eSpark-Backup/dustinm-lampleddriver/Design-Files/Knob-PCB-v1.0/Deliverables/Renderings/2D-C-view.png

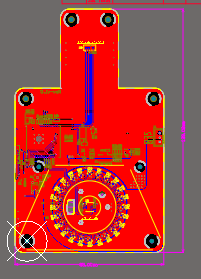
Design-Files/Knob-PCB-v1.0/Deliverables/Renderings/2D-C-view.png
