eSpark-Backup/dustinm-lampleddriver/Design-Files/Knob-PCB-v1.0/Deliverables/Renderings/3D-TOP-view.png

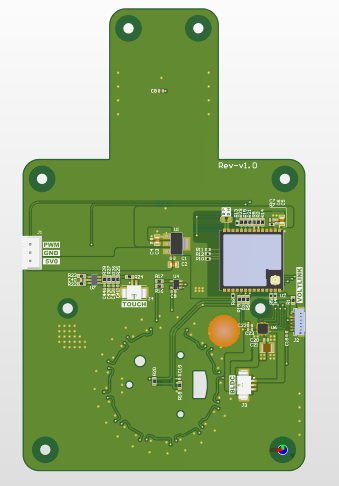
Design-Files/Knob-PCB-v1.0/Deliverables/Renderings/3D-TOP-view.png
