eSpark-Backup/dustinm-lampleddriver/Design-Files/Power-PCB-v1.0/Deliverables/Renderings/Power_PCB.JPG

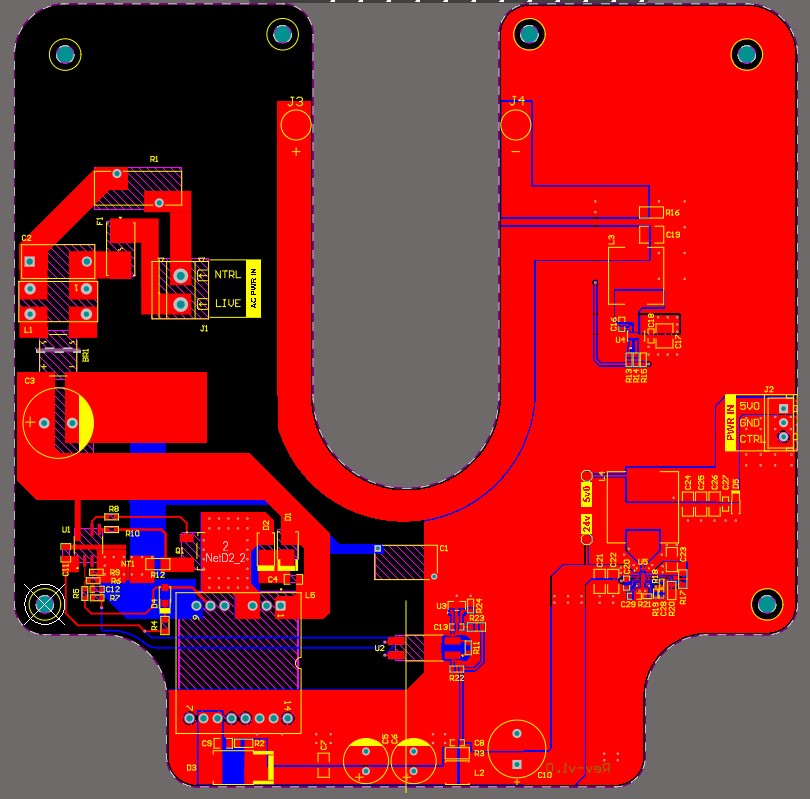
Design-Files/Power-PCB-v1.0/Deliverables/Renderings/Power_PCB.JPG
