eSpark-Backup/dustinm-lampleddriver/Design-Files/Power-PCB-v1.0/Deliverables/Renderings/Power_PCB_BOTTOM3D.jpg

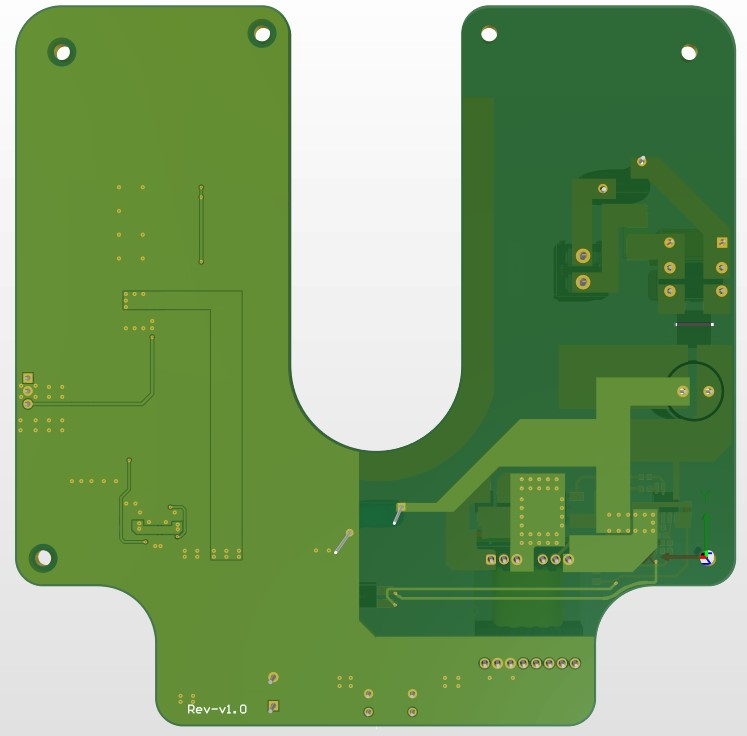
Design-Files/Power-PCB-v1.0/Deliverables/Renderings/Power_PCB_BOTTOM3D.jpg
