eSpark-Backup/dustinm-lampleddriver/docs/Client-Files/Enclosure-Files/Initial-Draft/lamp body.png

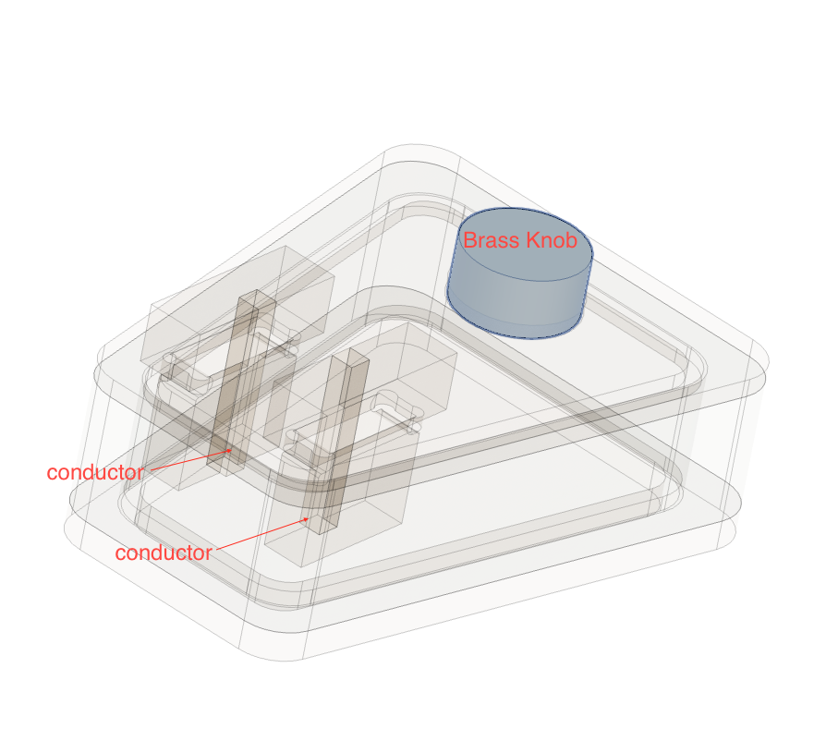
docs/Client-Files/Enclosure-Files/Initial-Draft/lamp body.png
