eSpark-Backup/dustinm-lampleddriver/Design-Files/Knob-PCB-v1.0/Deliverables/BOM/Client-BOM_Knob-PCB-v1.0.xlsx

# | Item Type | Designator | Description | Footprint | Manufacturer Part Number | Manufacturer | Value | Quantity | Remarks
1 | Capacitors | C1, C4, C6, C8, C9, C10, C11, C12, C13, C14, C15, C16, C17, C18, C19, C20, C22, C23, C24, C25, C26, C27, C28, C29, C30, C31, C32, C33, C34, C35, C36, C37, C38, C39, C40 | CAP CER 0.1UF 25V X7R 0402 | Cap-0402 | GRM155R71E104KE14D | Murata | 0.1uF | 35
2 | Capacitors | C2, C5 | CAP CER 10UF 25V X7R 0805 | Cap-0805 | GRM21BZ71E106KE15L | Murata | 10uF | 2
3 | Capacitor | C3 | CAP CER 22UF 10V X7R 0805 | Cap-0805 | GRM21BZ71A226ME15L | Murata | 22uF | 1
4 | Capacitor | C7 | CAP CER 0.1UF 16V X7R 0402 | Cap-0402 | GRM155R71C104KA88D | Murata | 0.1uF | 1
5 | Capacitor | C21 | CAP CER 22UF 25V X7R 1210 | Cap-1210 | GRM32ER71E226KE15L | Murata | 22uF | 1
6 | Capacitor | C41 | CAP CER 47PF 50V C0G/NP0 0402 | Cap-0402 | GCM1555C1H470FA16D | Murata | 47pF | 1
7 | Capacitor | C42 | CAP CER 30PF 50V C0G/NPO 0402 | Cap-0402 | CC0402JRNPO9BN300 | Yageo | 30pF | 1
8 | Capacitor | C43 | CAP CER 22PF 50V C0G/NPO 0402 | Cap-0402 | CC0402JRNPO9BN220 | Yageo | 22PF | 1
9 | Capacitors | C44 | CAP CER 13PF 50V C0G/NP0 0402 | Cap-0402 | CC0402FRNPO9BN130 | Yageo | 13pF | 1
10 | Wire To Board Connector | J1 | 1x3P 3P XH 1 Tin 2.5mm 3 -25℃~+85℃ Brass 3A Straight Plugin,P=2.5mm Wire To Board Connector ROHS | XH-3A | XH-3A | HCTL | - | 1
11 | Connector | J2 | 1x6P SH 1 1mm 6 SMD,P=1mm Wire To Board / Wire To Wire Connector ROHS | Voltlink Target | C145963 | BOOMELE | - | 1
12 | Headers and Wire Housings | J3 | CONN HEADER SMD R/A 3POS 1.25MM | 53261-0371 | 53261-0371 | Molex | - | 1
13 | Headers and Wire Housings | J4 | CONN HEADER SMD R/A 2POS 1.25MM | 532610271 | 53261-0271 | Molex | - | 1
14 | RGB LED | LED1, LED2, LED3, LED4, LED5, LED6, LED7, LED8, LED9, LED10, LED11, LED12, LED13, LED14, LED15, LED16, LED17, LED18, LED19, LED20, LED21, LED22, LED23, LED24 | 5mA -40℃~+80℃ RGB SMD,2x2mm Light Emitting Diodes (LED) ROHS | SK6812-EC20 | SK6812-EC20 | OPSCO Optoelectronics | - | 24
15 | Resistor | R1, R15, R18, R19, R21, R22, R23, R24, R27, R29 | RES 0 OHM JUMPER 1/10W 0603 | Res-0603 | RC0603JR-070RL | Yageo | 0R | 10
16 | Resistor | R2, R3, R8, R9 | RES 2.2K OHM 1% 1/10W 0603 | Res-0603 | RC0603FR-072K2L | Yageo | 2.2K | 4
17 | Resistor | R4, R5, R6, R7, R10, R11, R12, R13 | RES 10K OHM 1% 1/16W 0402 | Res-0402 | RC0402FR-0710KL | Yageo | 10K | 8
18 | Resistor | R14, R16, R20 | RES 0 OHM JUMPER 1/10W 0603 | Res-0603 | RC0603JR-070RL | Yageo | DNP | 3 | DO NOT PLACE
19 | Resistor | R17 | RES 470 OHM 1% 1/10W 0603 | Res-0603 | RC0603FR-07470RL | Yageo | 470R | 1
20 | IC | U1 | SOT-223 Linear Voltage Regulators (LDO) ROHS | SOT- 223 | AMS1117-3.3 | GUOXIN JIAPIN SEMICONDUCTOR | - | 1
21 | Module | U2 | RF TXRX MOD BT WIFI PCB TH SMD | ESP32-C6-WROOM-1U-N8 | ESP32-C6-WROOM-1U-N8 | Espressif Systems | - | 1
22 | Sensors | U3 | SENSOR OPT AMBIENT 4 SMD J LEAD | VEML7700-TT | VEML7700-TT | Vishay Semiconductors | - | 1
23 | IC | U4 | IC BUF NON-INVERT 5.5V SOT23-5 | SOT-23-5 | SN74LV1T34DBVR | Texas Instruments | - | 1
24 | Sensor | U5 | SOP-8 Position Sensors ROHS | SOP-8 | MT6701CT-STD | Magn Tek | - | 1
25 | IC | U6 | BLDC MOTOR DRIVER 2-11V QFN20 | 20-QFN(3x3) | TMC6300-LA-T | Trinamic | - | 1
26 | IC | U7 | SOT-23-6L Touch Sensors ROHS | SOT-23-6 | TTP233H-BA6 | Tontek Design Tech | - | 1
27 | Peripheral | Antenna | high gain embedded 2.4g Wifi U.FL Ble FPC Flexible Antenna ufl internal Antenna flexible Ble BT Antenna for ESP32 Module | custom | ZXWIFI24I408 | Signal Plus | - | 1
28 | Peripheral | Motor | Three Phase Brushless Gimbal Stabilizer Motor | custom | EM3215 3-Phase Brushless DC Motor | SparkFun | - | 1
