eSpark-Backup/dustinm-lampleddriver/Design-Files/Power-PCB-v1.0/Deliverables/BOM/Client-BOM_Power-PCB-v1.0.xlsx

# | Item Type | Designator | Description | Footprint | Manufacturer Part Number | Manufacturer | value | Quantity | Remarks
1 | Bridge Rectifire | BR1 | 1.1V@4A 4A 1000V UMSB Bridge Rectifiers ROHS | - | MSB40M | GOODWORK | - | 1
2 | Capacitor | C1 | 1.5nF ±20% X1,Y1 Plugin,P=10mm Safety Capacitors ROHS | - | DCF152M36Y5UG6BL0AA | SHM | 1.5nF | 1
3 | Capacitor | C2 | 100nF ±10% X2 275V Plugin,P=10mm Safety Capacitors ROHS | - | MP2104K27C3X6LC | SRD(Shenzhen Sincerity Tech) | 100nF | 1
4 | Capacitor | C3 | 82uF 250V 1.35Ω@100kHz ±20% 1.27A@100kHz Plugin,D12.5xL20mm Aluminum Electrolytic Capacitors - Leaded ROHS | - | LKML2002E820MF | Ymin | 82uF | 1
5 | Capacitor | C4, C9 | 630V 1000pF X7R ±10% 0805 Multilayer Ceramic Capacitors MLCC - SMD/SMT ROHS | Cap-0805 | 0805B102K631NT | FH (Guangdong Fenghua Advanced Tech) | 1000pF | 2
6 | Capacitor | C5, C6 | 220uF 35V 472.5mA@120Hz ±20% Plugin,D8xL11.5mm Aluminum Electrolytic Capacitors - Leaded ROHS | - | 35ZLH220MEFC8X11.5 | Rubycon | 220uF | 2
7 | Capacitor | C7 | CAP CER 6.8UF 35V X7R 1206 | Cap-1206 | C3216X7R1V685K160AC | TDK Corporation | 6.8uF | 1
8 | Capacitors | C8, C16, C18 | CAP CER 0.1UF 50V X7R 0603 | Cap-0603 | GCM188R71H104KA57J | Murata | 0.1uF | 3
9 | Capacitor | C10 | CAP ALUM 470UF 20% 35V RADIAL | - |  |  | 470uF | 1
10 | Capacitor | C11 | 35V 10uF X5R ±10% 0805 Multilayer Ceramic Capacitors MLCC - SMD/SMT ROHS | Cap-0805 | CGA0805X5R106K350MT | HRE | 10uF | 1
11 | Capacitors | C12 | CAP CER 0.047UF 50V X7R 0603 | Cap-0603 | CC0603KRX7R9BB473 | Yageo | 47nF | 1
12 | Capacitors | C13 | CAP CER 560PF 50V X7R 0603 | Cap-0603 | CC0603KRX7R9BB561 | Yageo | 560pF | 1
13 | Capacitors | C17, C19 | CAP CER 10UF 50V X7R 1210 | Cap-1210 | CC1210KKX7R9BB106 | Yageo | 10uF | 2
14 | Capacitor | C20, C27 | CAP CER 0.1UF 50V X7R 0603 | Cap-0603 |  |  | 0.1uF | 2
15 | Capacitor | C21 | CAP CER 4.7UF 50V X7R 1206 | Cap-1206 | UMK316AB7475KL-T | Taiyo Yuden | 4.7uF | 1
16 | Capacitor | C22, C23 | CAP CER 0.22UF 50V X7R 1206 | Cap-1206 | CC1206JKX7R9BB224 | Yageo | 220nF | 2
17 | Capacitor | C24, C25, C26 | CAP CER 47UF 25V X5R 1206 | Cap-1206 | GRM31CR61E476ME44L | Murata | 47uF | 3
18 | Capacitor | C28 | CAP CER 6.8PF 50V C0G/NPO 0402 | Cap-0402 | CC0402CRNPO9BN6R8 | Yageo | 6.8pF | 1
19 | Capacitor | C29 | CAP CER 1UF 50V X5R 0603 | Cap-0603 | CL10A105KB8NNNC | Samsung | 1uF | 1
20 | TVS Diodes | D1 | TVS DIODE 170VWM 275VC SMB | SMB_ | SMBJ170A-TR | STMicroelectronics | - | 1
21 | Diodes | D2 | DIODE STANDARD 1000V 1A SMA | SMA(DO-214AC) | US1M-13-F | Diodes | - | 1
22 | Diode | D3 | 200V Independent Type 4A 860mV@4A SMC(DO-214AB) Schottky Diodes ROHS | SMC | MBRS4201T3G | FUXINSEMI | - | 1
23 | Schottky Diodes | D4 | DIODE SCHOTTKY 100V 1A SOD123W | SOD-123W | PMEG10010ELRX | Nexperia | - | 1
24 | (TVS/ESD) | D5 | 6V 5V SOD-123 ESD and Surge Protection (TVS/ESD) ROHS | SOD-123 | AZ3005-01G | AMAZING | - | 1
25 | Fuses | F1 | FUSE BRD MNT 3A 125VAC/VDC 2SMD | - | 0154003.DR | Littelfuse | - | 1
26 | Terminal Block | J1 | 1x2P 18A -40℃~+105℃ 250V Black 12~30 Straight pin 5.08mm 2.5 1 2 Plugin,P=5.08mm Screw terminal ROHS | - | DB128L-5.08-2P-BK-S | DIBO | - | 1
27 | Wire To Board Connector | J2 | 1x3P 3P XH 1 Tin 2.5mm 3 -25℃~+85℃ Brass 3A Straight Plugin,P=2.5mm Wire To Board Connector ROHS | - | XH-3A | HCTL | - | 1
28 | Fixed Inductors | L1 | CMC 1MH 2A 2LN TH | - | 744821201 | Wurth Electronics | - | 1
29 | Inductor | L2 | 3.4A 1uH ±30% 5.9A SMD,4x4mm Power Inductors ROHS | - | CR4030-1R0N | Ceaiya | - | 1
30 | Inductor | L3 | 4.5A 4.7uH ±20% SMD,10.1x10.1mm Power Inductors ROHS | - | YSLF1045-4R7M | YJYCOIN | 4.7uH | 1
31 | Inductors | L4 | FIXED IND 15UH 9A 28 MOHM SMD | - | SRP1265A-150M | Bourns | 15uH | 1
32 | Transformer | L5 | XFMR FLYBACK AC/DC CONV 280UH TH | - | 750343466 | Wurth Electronics | - | 1
33 | Mosfet | Q1 | 650V 7A 0.6Ω@10V,3.5A 63W 4V 1 N-channel TO-252-2 MOSFETs ROHS | TO-252-2L | SM600R65CT9RL | SPS | - | 1
34 | Thermistor | R1 | 5Ω 5A 4W 2800K ±10% Plugin,P=7.5mm NTC Thermistors ROHS | - | MF72 5D13 | Nanjing Shiheng Elec | - | 1
35 | Resistors | R2, R4 | RES 10 OHM 5% 1/8W 0805 | RES-0805 | RC0805JR-0710RL | Yageo | 10R | 2
36 | Resistor | R3 | 0.25W Thick Film Resistors 200V ±1% ±200ppm/℃ 2Ω 1206 Chip Resistor - Surface Mount ROHS | Res-1206 | FRC1206F2R00TS | FOJAN | 2R | 1
37 | Resistor | R5 | RES 75K OHM 1% 1/10W 0603 | Res-0603 | RC0603FR-0775KL | Yageo | 75K | 1
38 | Resistors | R6 | RES 24K OHM 5% 1/10W 0603 | Res-0603 | RC0603JR-0724KL | Yageo | 24K | 1
39 | Resistors | R7, R15 | RES 100K OHM 1% 1/10W 0603 | Res-0603 | RC0603FR-07100KL | Yageo | 100K | 2
40 | Resistor | R8, R13 | RES 0 OHM JUMPER 1/10W 0603 | Res-0603 | RC0603JR-070RL | Yageo | 0R | 2
41 | Resistors | R9 | RES 22K OHM 1% 1/10W 0603 | Res-0603 | RC0603FR-0722KL | Yageo | 22K | 1
42 | Resistors | R10 | RES 2.7K OHM 5% 1/10W 0603 | Res-0603 | RC0603JR-072K7L | Yageo | 2.7K | 1
43 | Resistor | R11, R14 | 0.1W Thick Film Resistors 75V ±100ppm/℃ ±1% 1kΩ 0603 Chip Resistor - Surface Mount ROHS | Res-0603 | 0603WAF1001T5E | UNI-ROYAL(Uniroyal Elec) | 1K | 2
44 | Resistor | R12 | 0.25W Thick Film Resistors 500V ±1% ±300ppm/℃ 0.43Ω 1206 Chip Resistor - Surface Mount ROHS | Res-1206 | FRL1206FR430TS | FOJAN | 0.43R | 1
45 | Resistor | R16 | RES 0.2 OHM 1% 1/2W 1206 | Res-1206 | PT1206FR-7W0R2L | Yageo | 0.2R | 1
46 | Resistor | R17 | RES SMD 698K OHM 0.1% 1/8W 0805 | RES-0805 | RT0805BRD07698KL | Yageo | 698K | 1
47 | Resistor | R18, R19 | RES SMD 100K OHM 0.1% 1/16W 0402 | Res-0402 | RT0402BRD07100KL | Yageo | 100K | 2
48 | Resistors | R20 | RES SMD 51.1K OHM 0.1% 1/8W 0805 | RES-0805 | RT0805BRD0751K1L | Yageo | 51.1K | 1
49 | Resistors | R21 | RES SMD 24.9KOHM 0.1% 1/16W 0402 | Res-0402 | RT0402BRD0724K9L | Yageo | 24.9K | 1
50 | Resistor | R22 | RES 1.5K OHM 1% 1/10W 0603 | Res-0603 | RC0603FR-071K5L | Yageo | 1.5K | 1
51 | Resistors | R23 | RES SMD 383K OHM 0.1% 1/8W 0805 | RES-0805 | RT0805BRD07383KL | Yageo | 383K | 1
52 | Resistors | R24 | RES 44.2K OHM 1% 1/10W 0603 | Res-0603 | RC0603FR-0744K2L | Yageo | 44.2K | 1
53 | IC | U1 | IC OFFLINE SWITCH FLYBACK 7SOIC | 7-SOIC | UCC28740DR | Texas Instruments | - | 1
54 | Optocouplers | U2 | OPTOISOLATOR 5KV 1CH TRANS 4-SMD | - | LTV-817S-TA1-C | Vishay Lite-On | - | 1
55 | IC | U3 | IC VREF SHUNT ADJ 0.5% SOT23-3 | SOT-23 | TL431BQDBZT | Texas Instruments | - | 1
56 | IC | U4 | IC LED DRV RGLTR PWM SOT23-THIN | SOT-23-6 | TPS92200D2DDCR | Texas Instruments | - | 1
57 | IC | U5 | IC REG BUCK ADJ 4A 13WQFN | 13-WQFN-HR (3x2) | LM60440AQRPKRQ1 | Texas Instruments | - | 1
