eSpark-Backup/dustinm-lampleddriver/Design-Files/Knob-PCB-v1.0/Deliverables/Supporting Files/Knob-v1.0.step

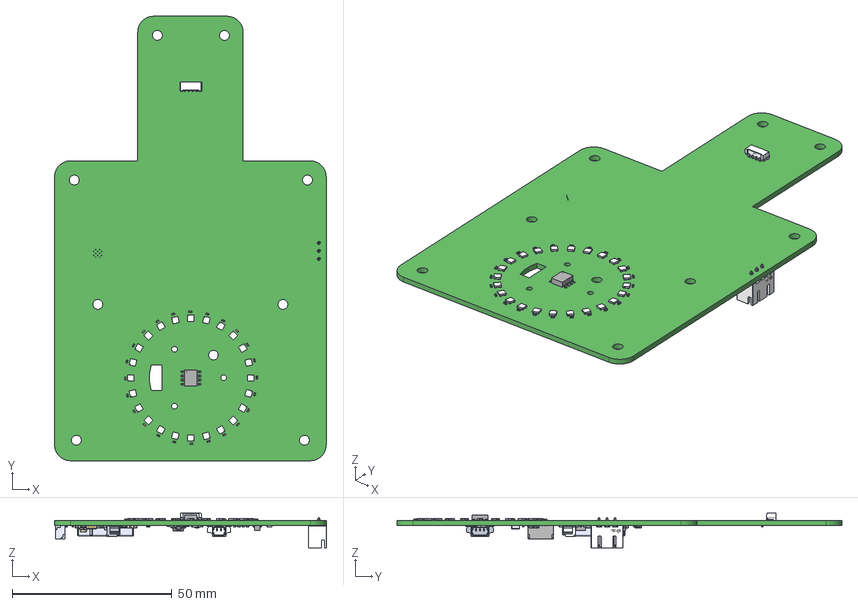
[picture p11: CAD file, 2025-07-10]
Design-Files/Knob-PCB-v1.0/Deliverables/Supporting Files/Knob-v1.0.step
85.1 x 139.1 x 10.9 mm
ESP32-C6-WROOM-1U-N8-board
antenna jack
21-0058I_MXM
User Library-RESC1608X05N x 21
User Library-RES_1005-0402 x 8
User Library-Capacitor 0402 x 40
OPSCO-Optoelectronics-SK6812-EC20_C2909058 x 24
EFM8UB30F40G-A-QFN20
TRANS_IRF7103TRPBF_INF
SN74LV1T34DBVR
User Library-SOT-223-1
SOLID.step.STEP.dwg.STEP.STEP.dwg
User Library-CAPC3225X10
User Library-0805 SMD Capacitor x 3
