eSpark-Backup/dustinm-lampleddriver/docs/Client-Files/Enclosure-Files/Casing-Draft-Final/knob-board-hole-update.step

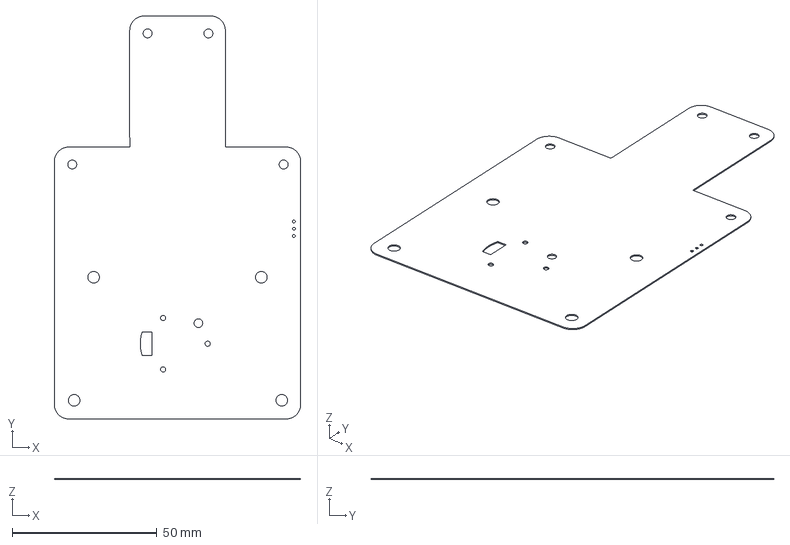
[picture p12: CAD file, 2025-06-02]
docs/Client-Files/Enclosure-Files/Casing-Draft-Final/knob-board-hole-update.step
85.0 x 139.1 x 0.411 mm
