eSpark-Backup/dustinm-lampleddriver/docs/Client-Files/Enclosure-Files/Final-Rectangular-Draft/Lamp_rectangular_base v2.step

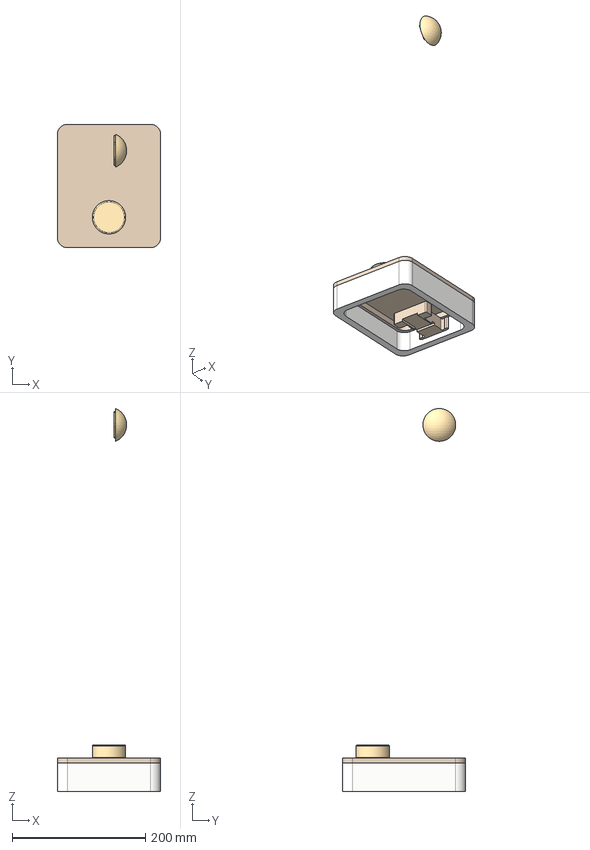
[picture p13: CAD file, 2025-04-04]
docs/Client-Files/Enclosure-Files/Final-Rectangular-Draft/Lamp_rectangular_base v2.step
155.0 x 185.0 x 574.6 mm
knob
semisphere left
rectangular top
tower hold down
concrete
