eSpark-Backup/dustinm-lampleddriver/docs/Client-Files/Enclosure-Files/Initial-Draft/lamp_base_with_konb_and_cord_hole.step

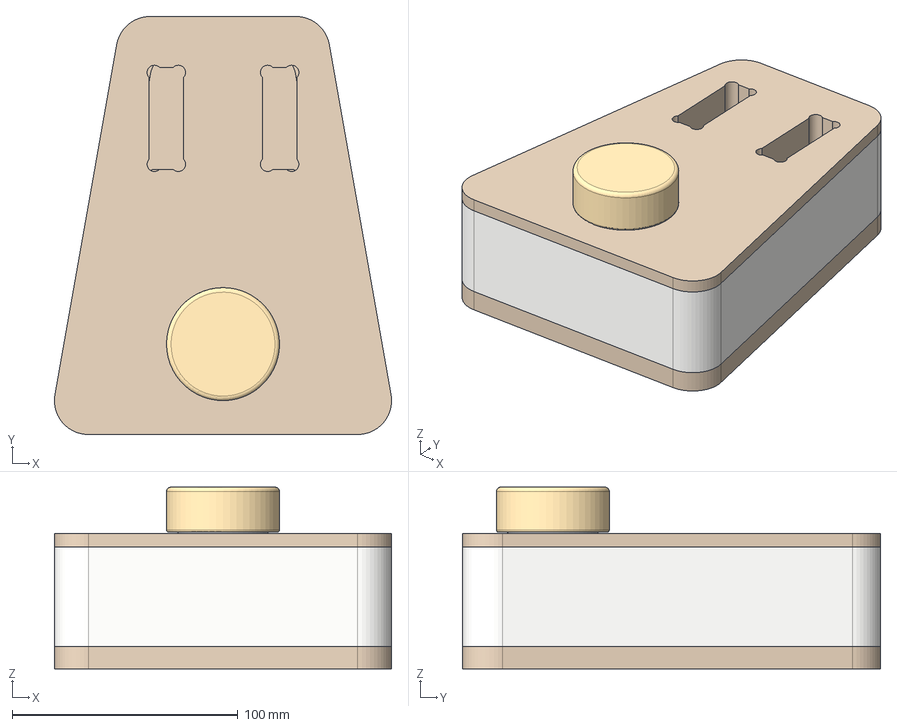
[picture p14: CAD file, 2025-03-17]
docs/Client-Files/Enclosure-Files/Initial-Draft/lamp_base_with_konb_and_cord_hole.step
149.2 x 185.0 x 80.5 mm
Stator
Rotor
knob
alt base top
alt base bottom
concrete
tower hold down
Main PCB
