eSpark-Backup/dustinm-lampleddriver/docs/Client-Files/Enclosure-Files/LED-Board-Draft/LED_board_mockup.step

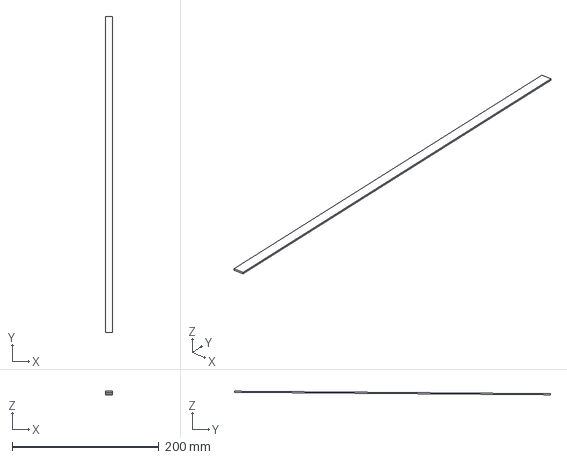
[picture p15: CAD file, 2025-03-17]
docs/Client-Files/Enclosure-Files/LED-Board-Draft/LED_board_mockup.step
10.0 x 431.0 x 4.92 mm
