eSpark-Backup/dustinm-lampleddriver/docs/Client-Files/Enclosure-Files/Triangular-Draft/Lamp_triangular_base v1.step

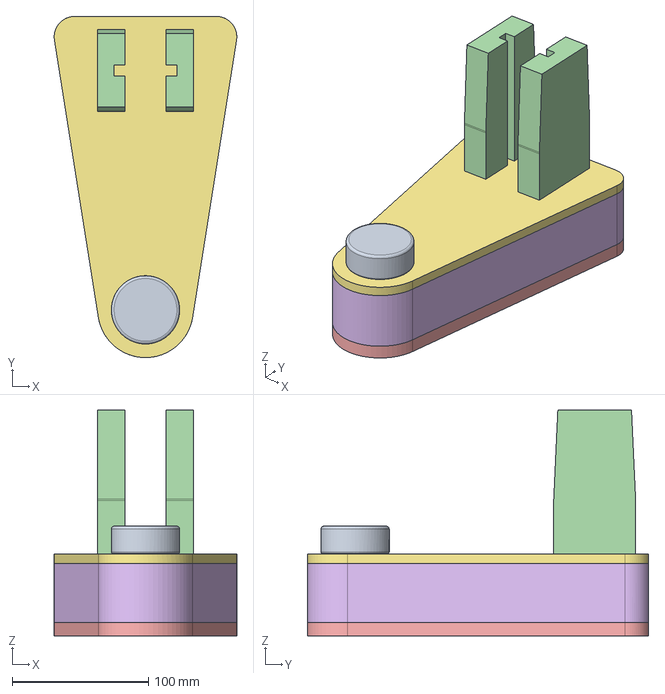
[picture p16: CAD file, 2025-03-18]
docs/Client-Files/Enclosure-Files/Triangular-Draft/Lamp_triangular_base v1.step
133.9 x 250.0 x 165.6 mm
Rotor
Stator
