eSpark-Backup/dustinm-lampleddriver/docs/Client-Files/Enclosure-Files/Casing-Draft-Final/knob_pcb_with_motor_mount_4-29-25.step

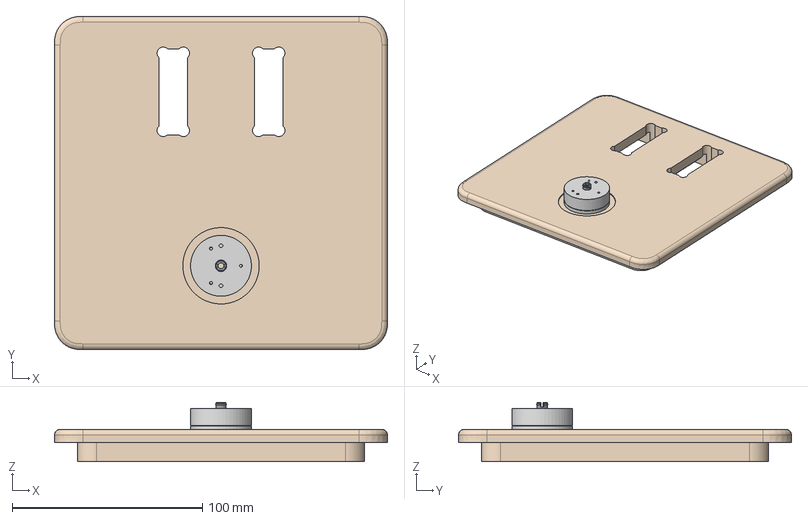
[picture p17: CAD file, 2025-05-02]
docs/Client-Files/Enclosure-Files/Casing-Draft-Final/knob_pcb_with_motor_mount_4-29-25.step
175.0 x 175.0 x 31.2 mm
Top
Stator
Rotor
MountBase v1
knob pcb (1)
