eSpark-Backup/dustinm-lampleddriver/docs/Client-Files/Enclosure-Files/Initial-Draft/lamp_body.step

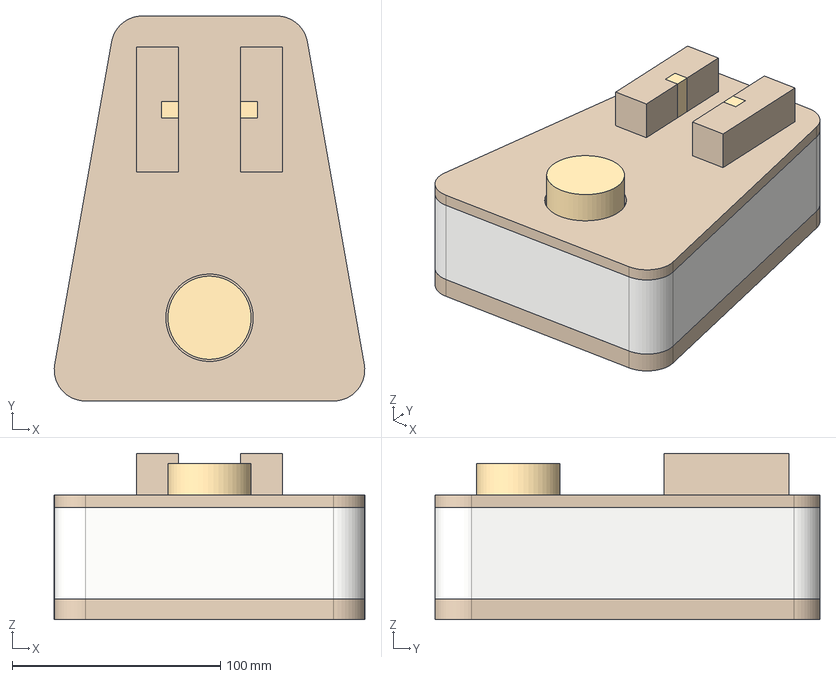
[picture p18: CAD file, 2025-03-11]
docs/Client-Files/Enclosure-Files/Initial-Draft/lamp_body.step
149.2 x 185.0 x 80.0 mm
knob
alt base top
tower left
bar
alt base bottom
concrete
