eSpark-Backup/dustinm-lampleddriver/docs/Client-Files/Enclosure-Files/Casing-Draft-Final/Lamp_rectangular_base v11_175mm.step

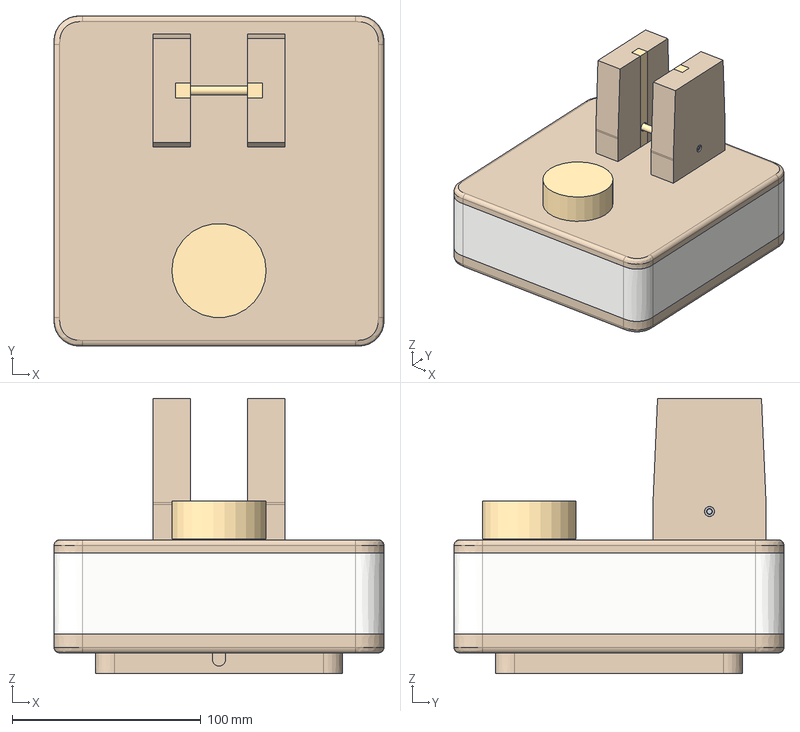
[picture p19: CAD file, 2025-04-11]
docs/Client-Files/Enclosure-Files/Casing-Draft-Final/Lamp_rectangular_base v11_175mm.step
175.0 x 175.0 x 146.0 mm
tower
spacer
bar
hold down
Main PCB
knob
Top
Middle
Base
Base Ring
95807A520_Stainless Steel Tapping Insert for Hardwood
91290A204_Alloy Steel Socket Head Screw
91290A123_Alloy Steel Socket Head Screw
91290A123_Alloy Steel Socket Head Screw_3 x 2
91290A123_Alloy Steel Socket Head Screw_1
91290A123_Alloy Steel Socket Head Screw_2
95807A520_Stainless Steel Tapping Insert for Hardwood_1
95631A050_Brass Tapping Inserts for Hardwood
magnet
sleeve
91290A204_Alloy Steel Socket Head Screw_1
95631A050_Brass Tapping Inserts for Hardwood_1
95631A050_Brass Tapping Inserts for Hardwood_2
95631A050_Brass Tapping Inserts for Hardwood_3
magnet base ring2
magnet base ring 3
magnet base ring 4
magnet bottom 3
magnet bottom 4
Stator
Rotor
tower(Mirror)
bar(Mirror)
sleeve(Mirror)
91290A123_Alloy Steel Socket Head Screw_4
90593A005_Black-Oxide Steel Hex Nut
cord reel
070-5643_6A
070-5643_coil
150-2107_6B x 2
96144A135_Fine-Thread Alloy Steel Socket Head Screw
Main PCB (1)
pogo pins
