eSpark-Backup/dustinm-lampleddriver/Design-Files/Knob-PCB-v1.0/Deliverables/Suppoting Files/Knob-v1.0.step

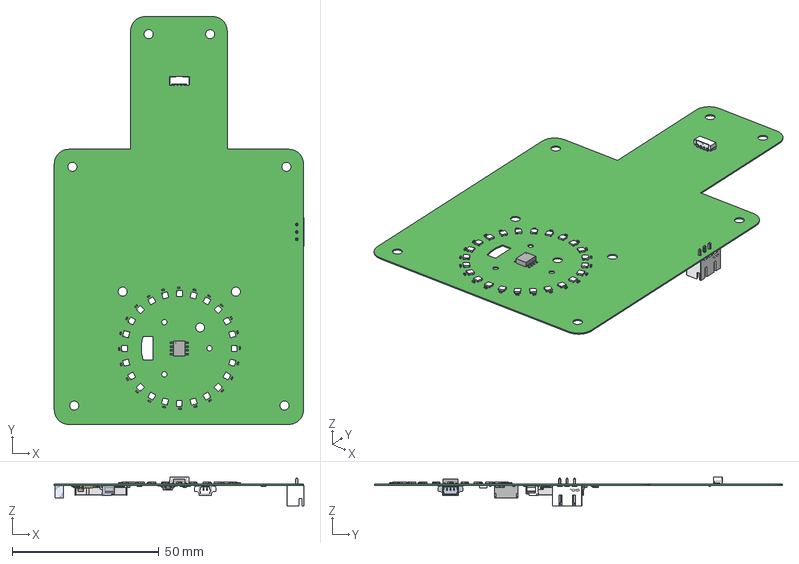
[picture p20: CAD file, 2025-06-02, an earlier design]
Design-Files/Knob-PCB-v1.0/Deliverables/Suppoting Files/Knob-v1.0.step
85.1 x 139.1 x 9.76 mm
OPSCO-Optoelectronics-SK6812-EC20_C2909058 x 24
User Library-RESC1608X05N x 13
ESP32-S3-WROOM-1U--3DModel-STEP-56544
User Library-Capacitor 0402 x 35
EFM8UB30F40G-A-QFN20
TRANS_IRF7103TRPBF_INF
SN74LV1T34DBVR
User Library-SOT-223-1
User Library-RES_1005-0402 x 7
SOLID.step.STEP.dwg.STEP.STEP.dwg
User Library-CAPC3225X10
User Library-0805 SMD Capacitor x 3
