eSpark-Backup/dustinm-lampleddriver/(list of files, cad)

Other CAD files:
Design-Files/Power-PCB-v1.0/Deliverables/Supporting Files/Power-PCB-v1.0D.DWG
Design-Files/Power-PCB-v1.0/Deliverables/Supporting Files/Power-PCB-v1.0.DXF
Design-Files/Knob-PCB-v1.0/Deliverables/Supporting Files/Knob-v1.0.DWG
Design-Files/Knob-PCB-v1.0/Deliverables/Supporting Files/Knob-v1.0.DXF
Design-Files/Knob-PCB-v1.0/Deliverables/Suppoting Files/Knob-v1.0.DXF
