eSpark-Backup/dustinm-lampleddriver/Design-Files/Knob-PCB-v1.0/Schematic/Knob-PCB-v1.0.pdf

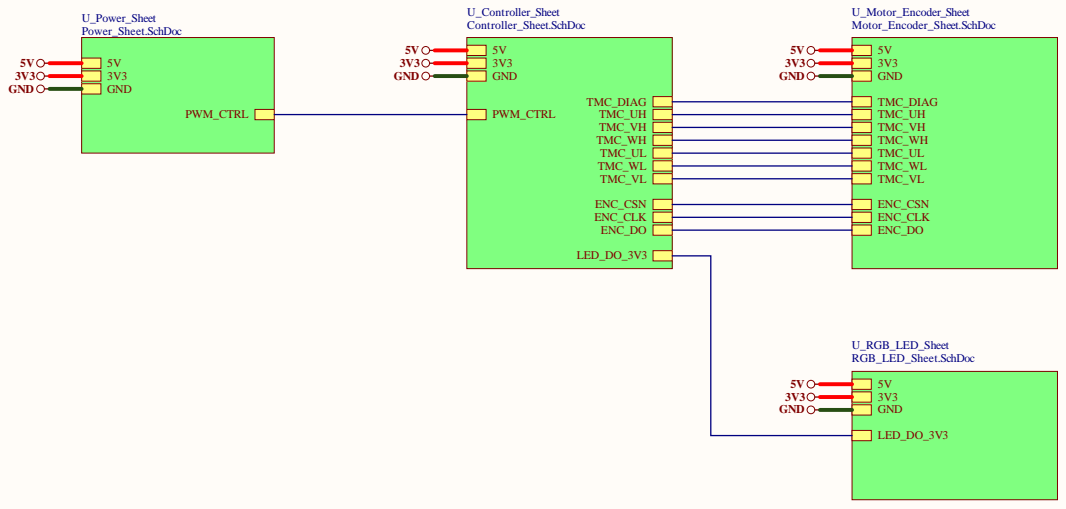
[picture p21: page 1]

Date: 07-Jul-25 | Page Num: 1

Drawn By: Huzaifa Ali | Page Total:

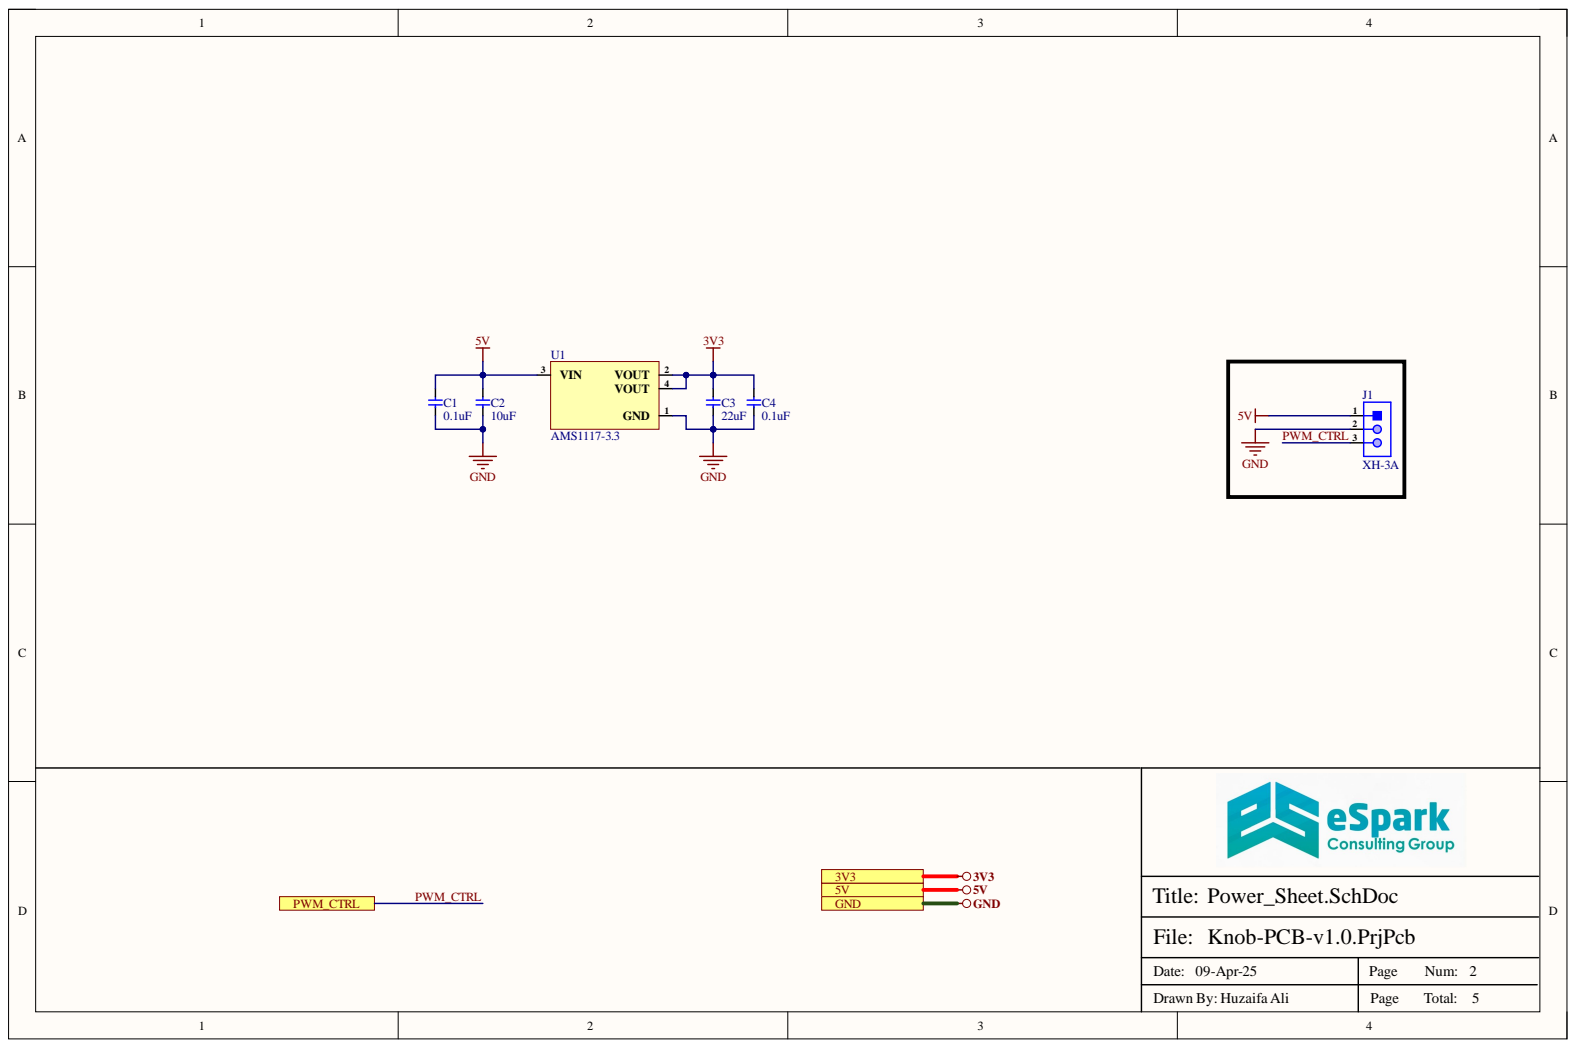
[picture p22: page 2]

Date: 09-Apr-25 | Page Num: 2

Drawn By: Huzaifa Ali | Page Total: 5

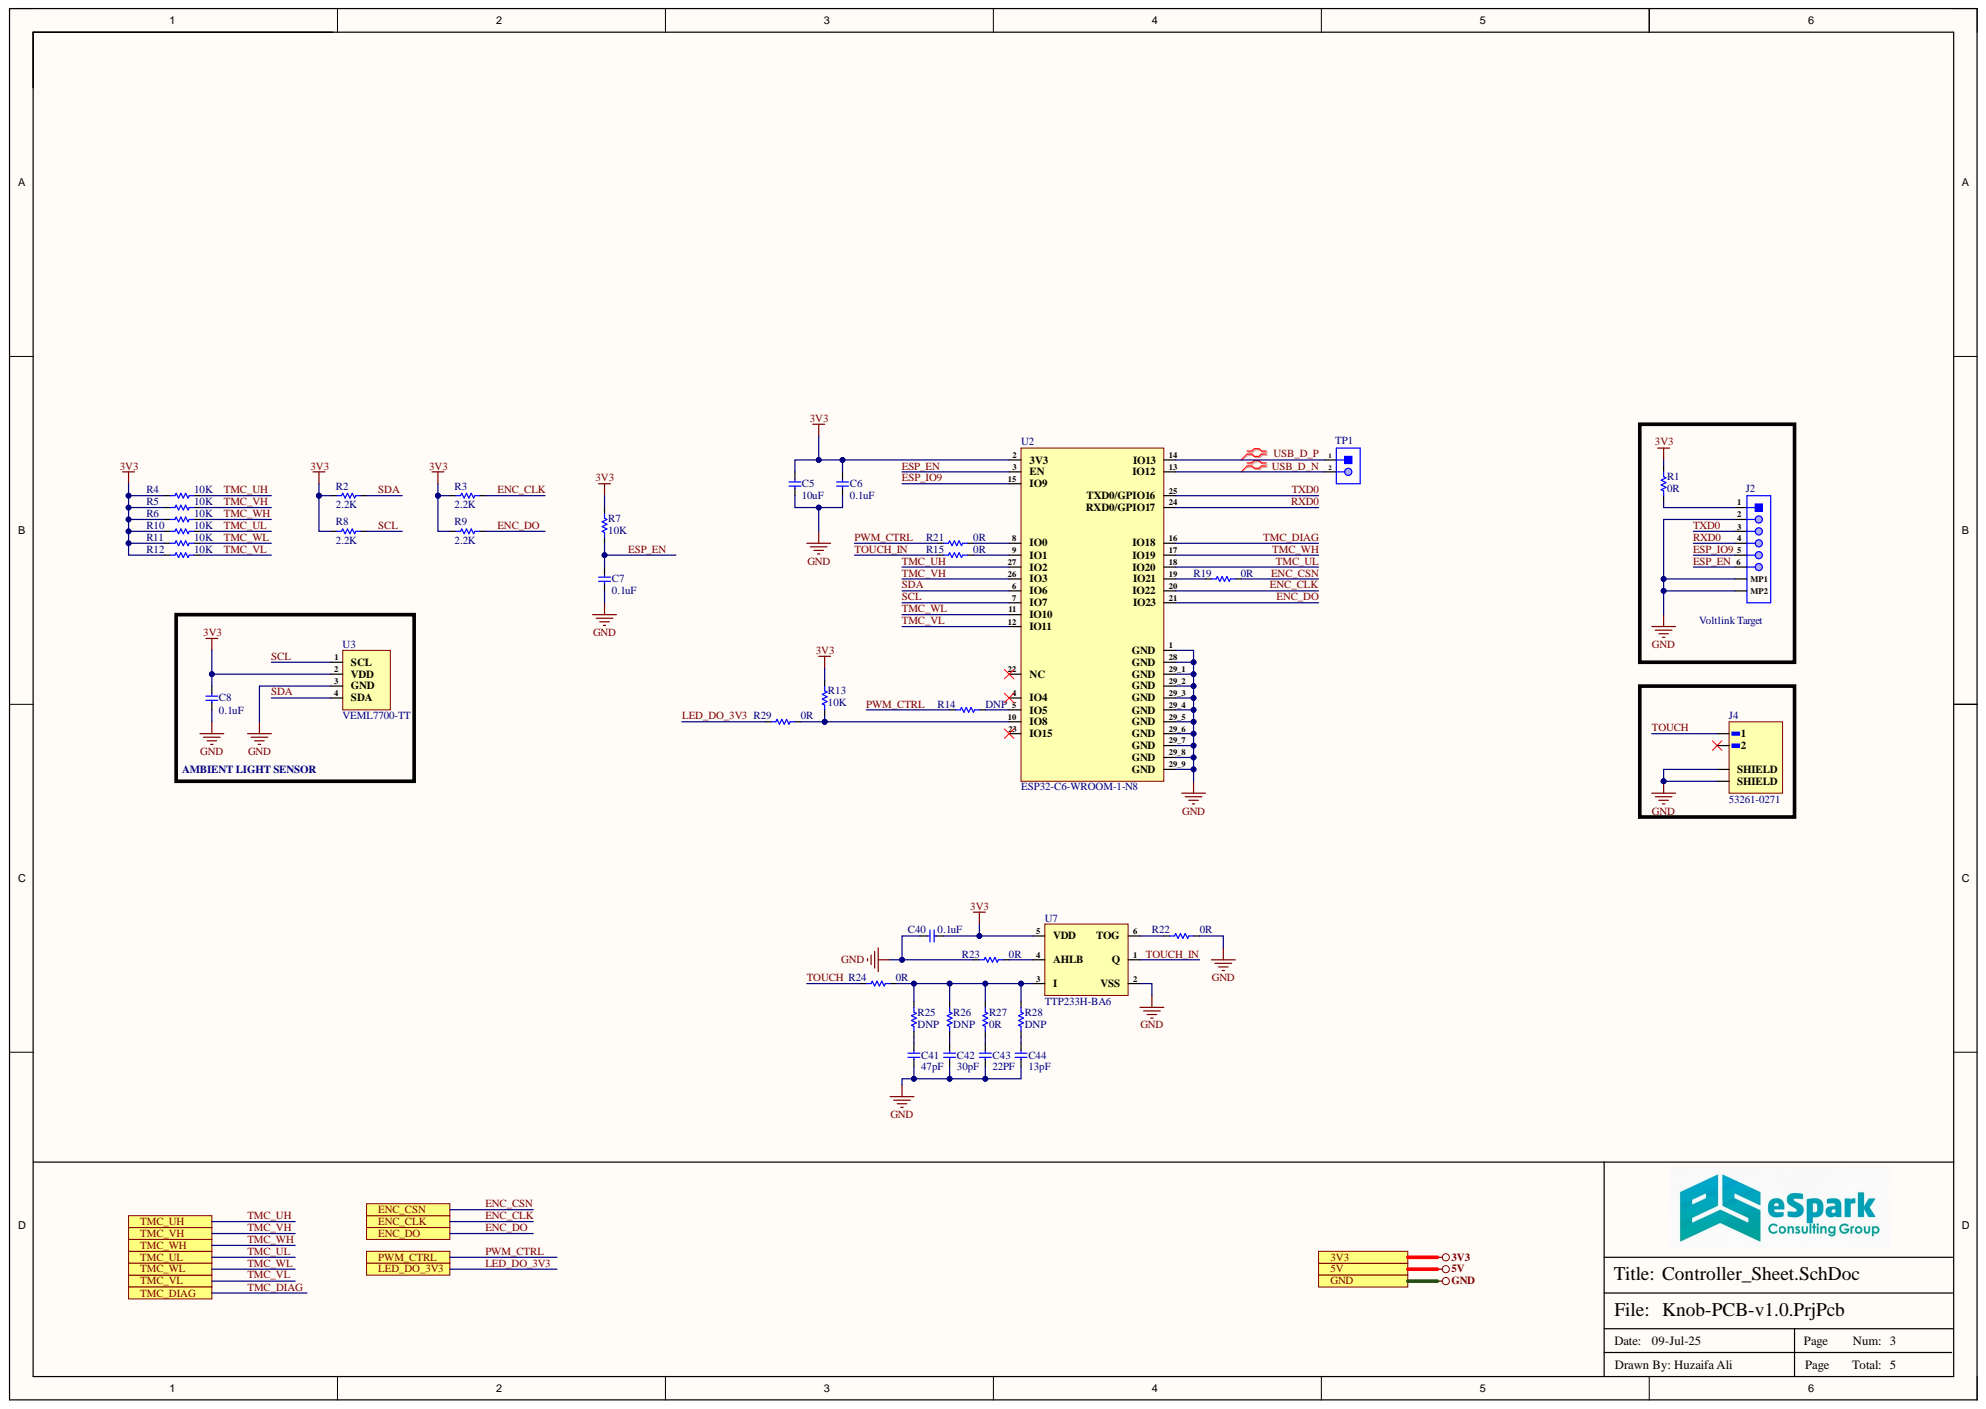
[picture p23: page 3]

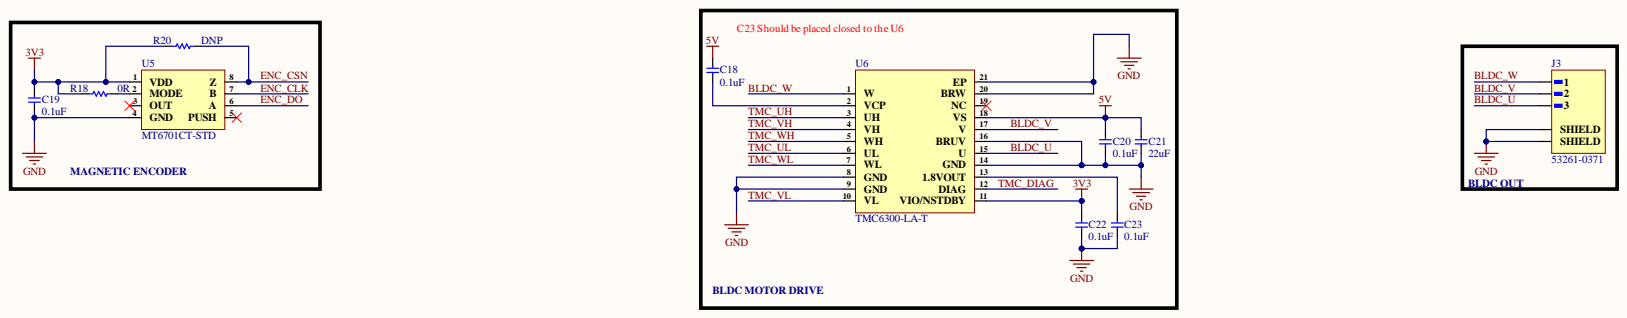
[picture p24: page 4]

C23 Should be placed closed to the U6

GND 9 | TMC_DIAG 3V3

TMC_VL

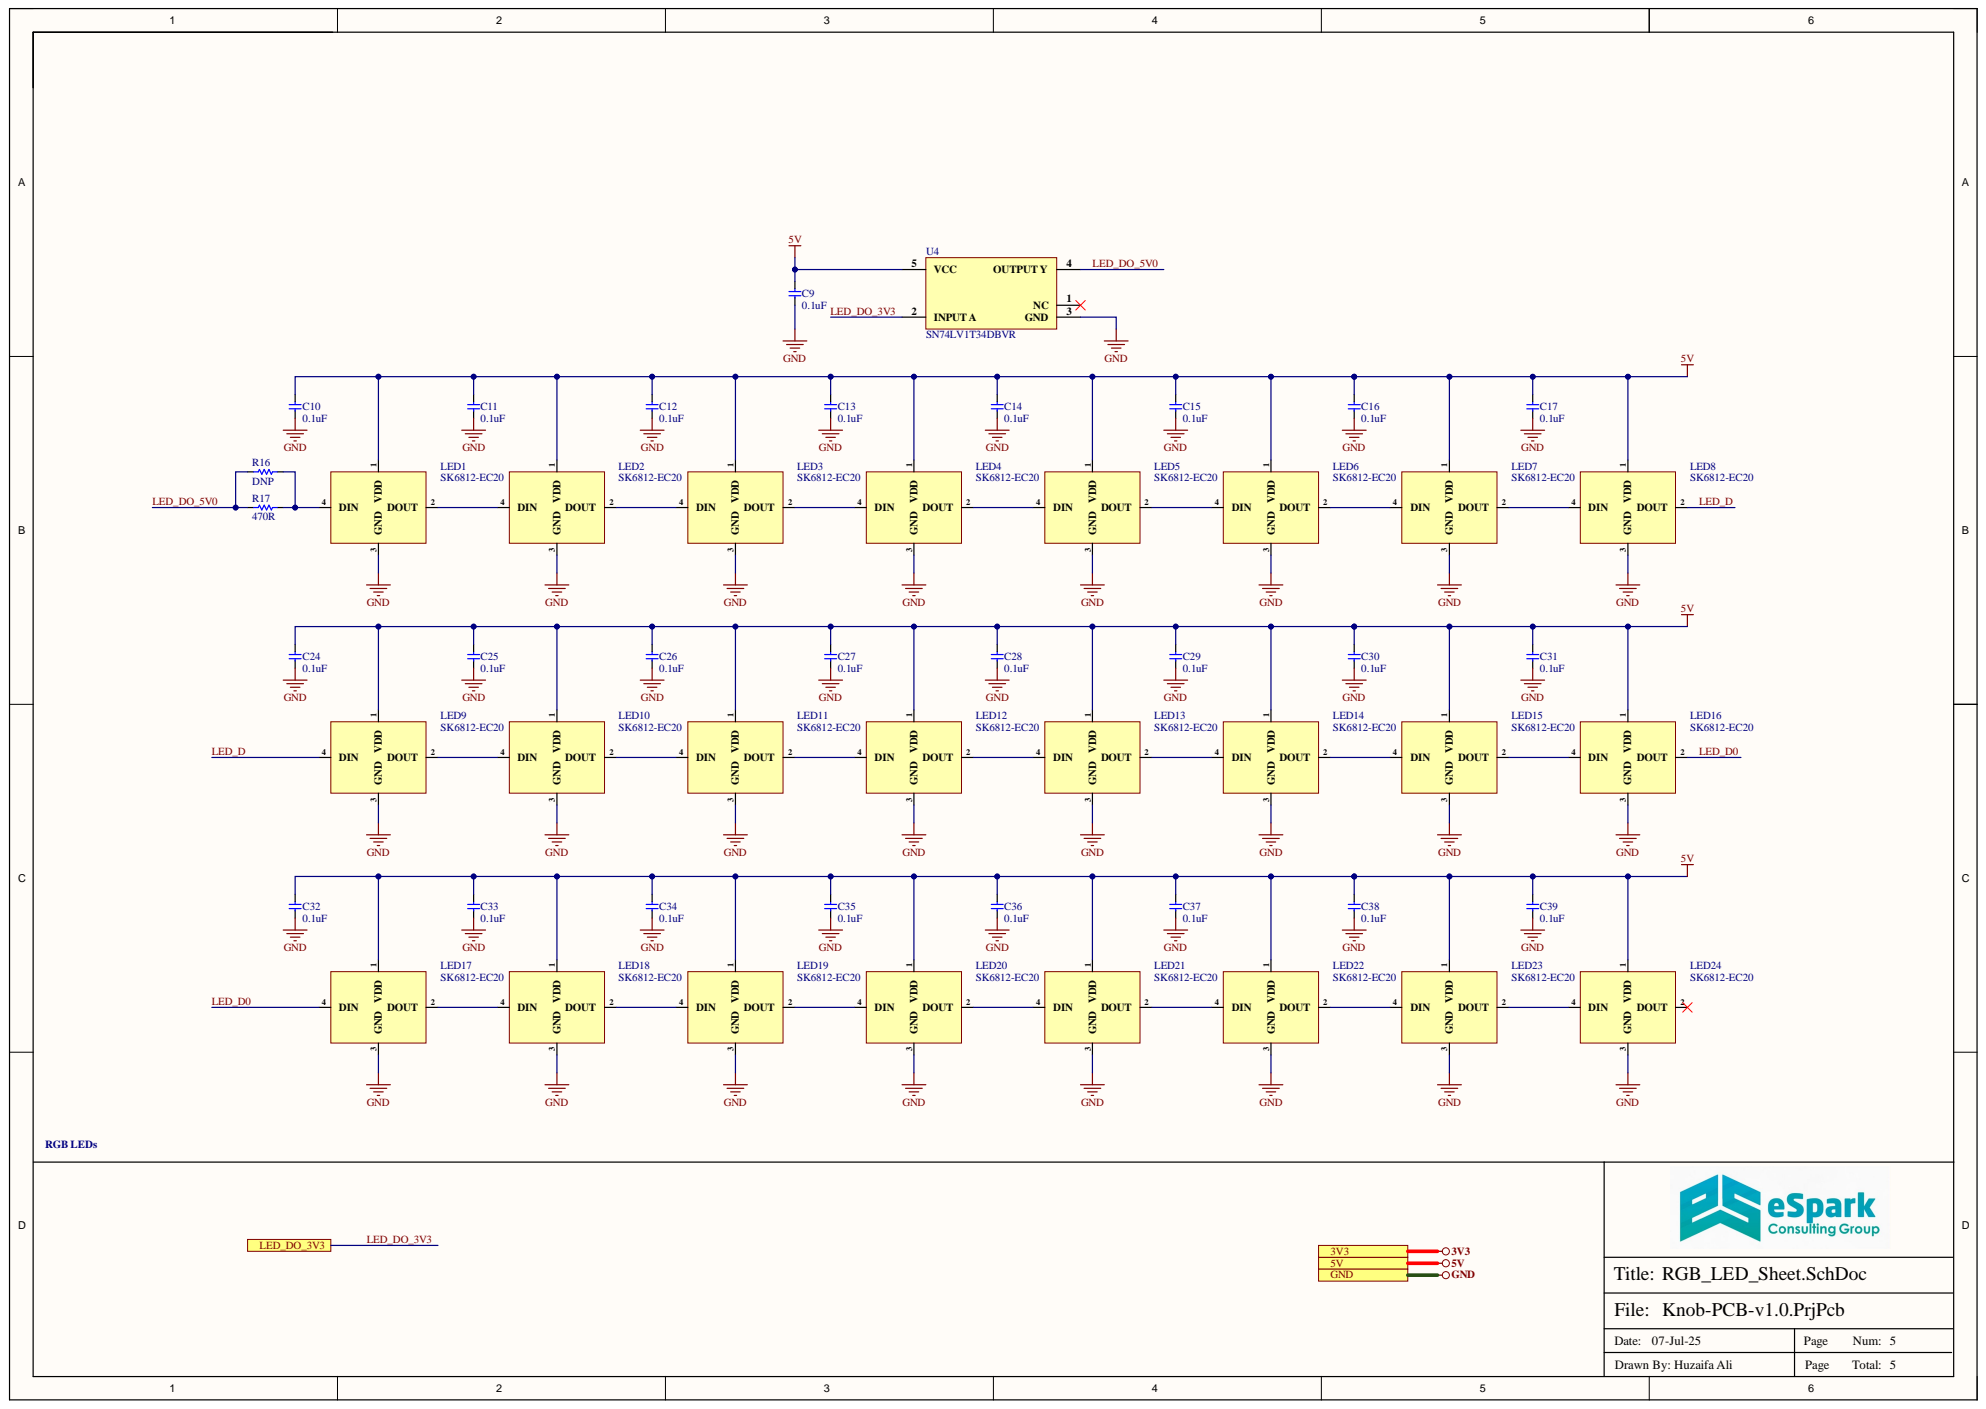
[picture p25: page 5]
