eSpark-Backup/dustinm-lampleddriver/Design-Files/Knob-PCB-v1.0/Deliverables/Assembly Drawings/Assembly_Drawing.pdf

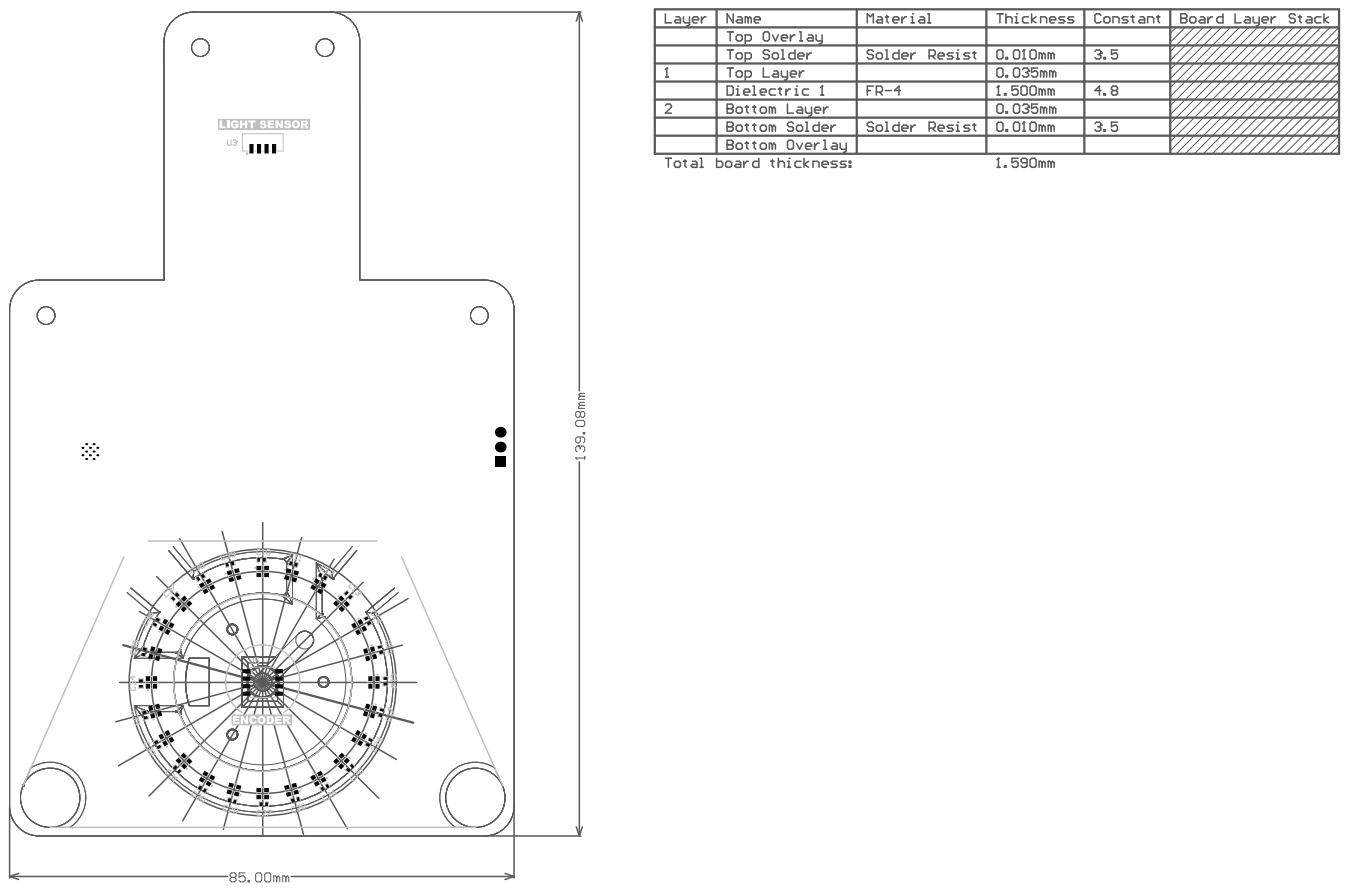
[picture p26: page 1]

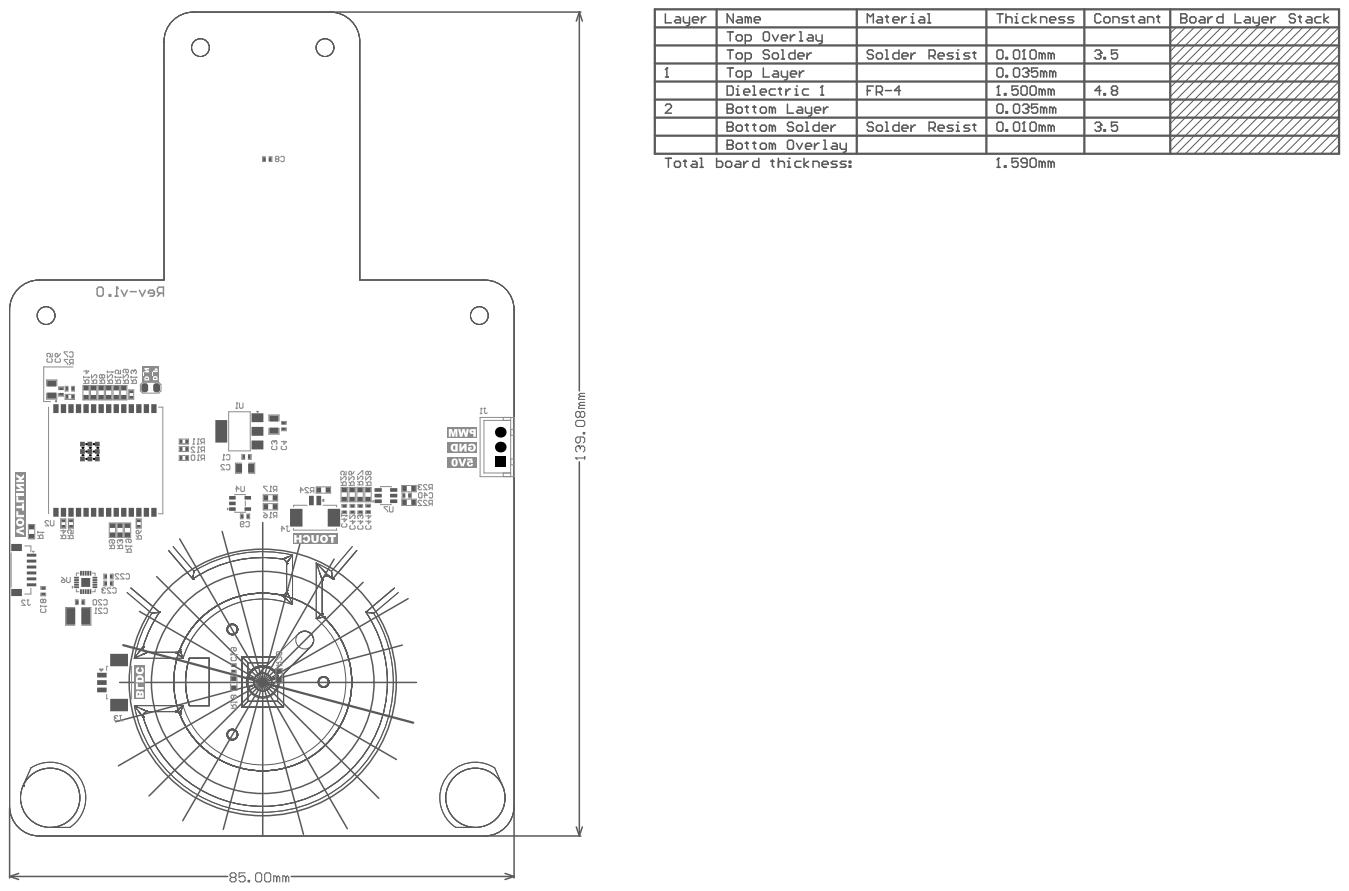
[picture p27: page 2]
