eSpark-Backup/dustinm-lampleddriver/Design-Files/Knob-PCB-v1.0/Deliverables/Assembly Drawings/Knob-PCB-v1.0.pdf

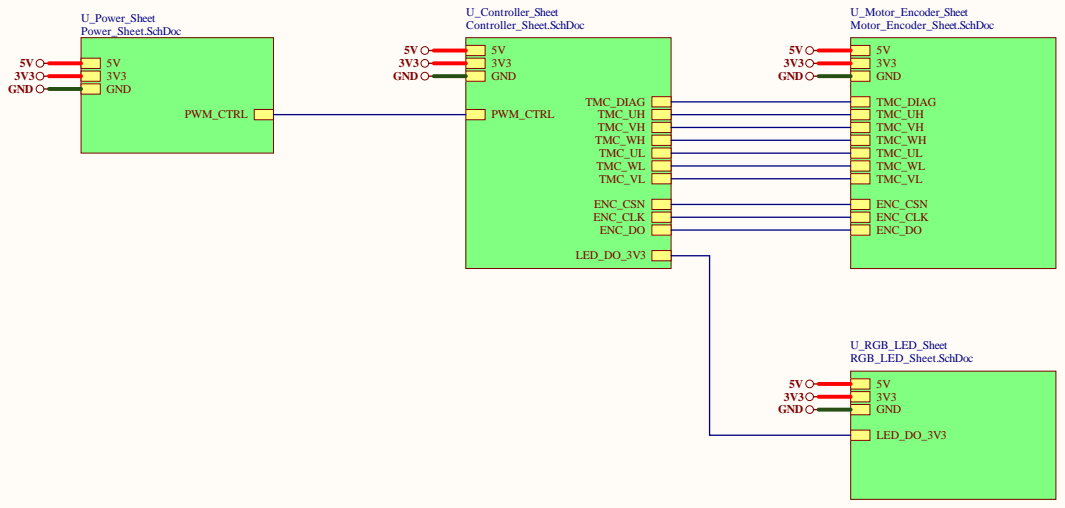
[picture p28: page 1]

Cannot open file
D:\eSpark-Consultants\eSpark-Hardware\Altium
Template\espark-consulting-group-800x300.jpg.
File does not exist.

Date: 7/10/2025 | Page Num: 1

Drawn By: Huzaifa Ali | Page Total:

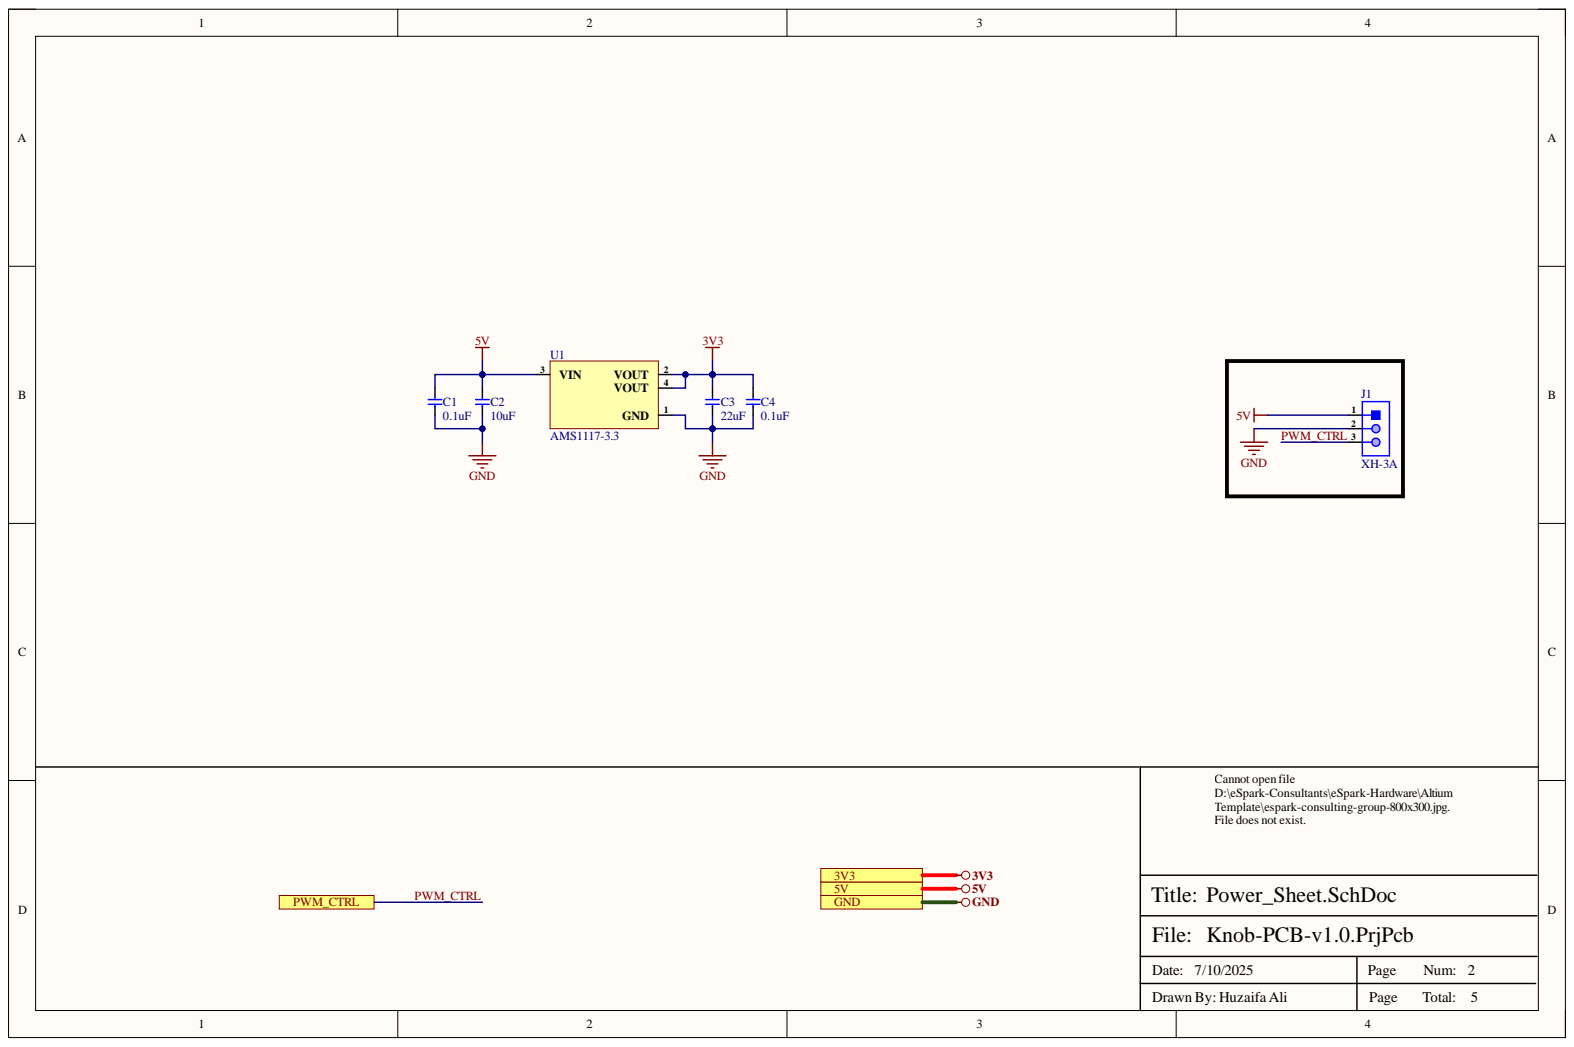
[picture p29: page 2]
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

Date: 7/10/2025 | Page Num: 2

Drawn By: Huzaifa Ali | Page Total: 5

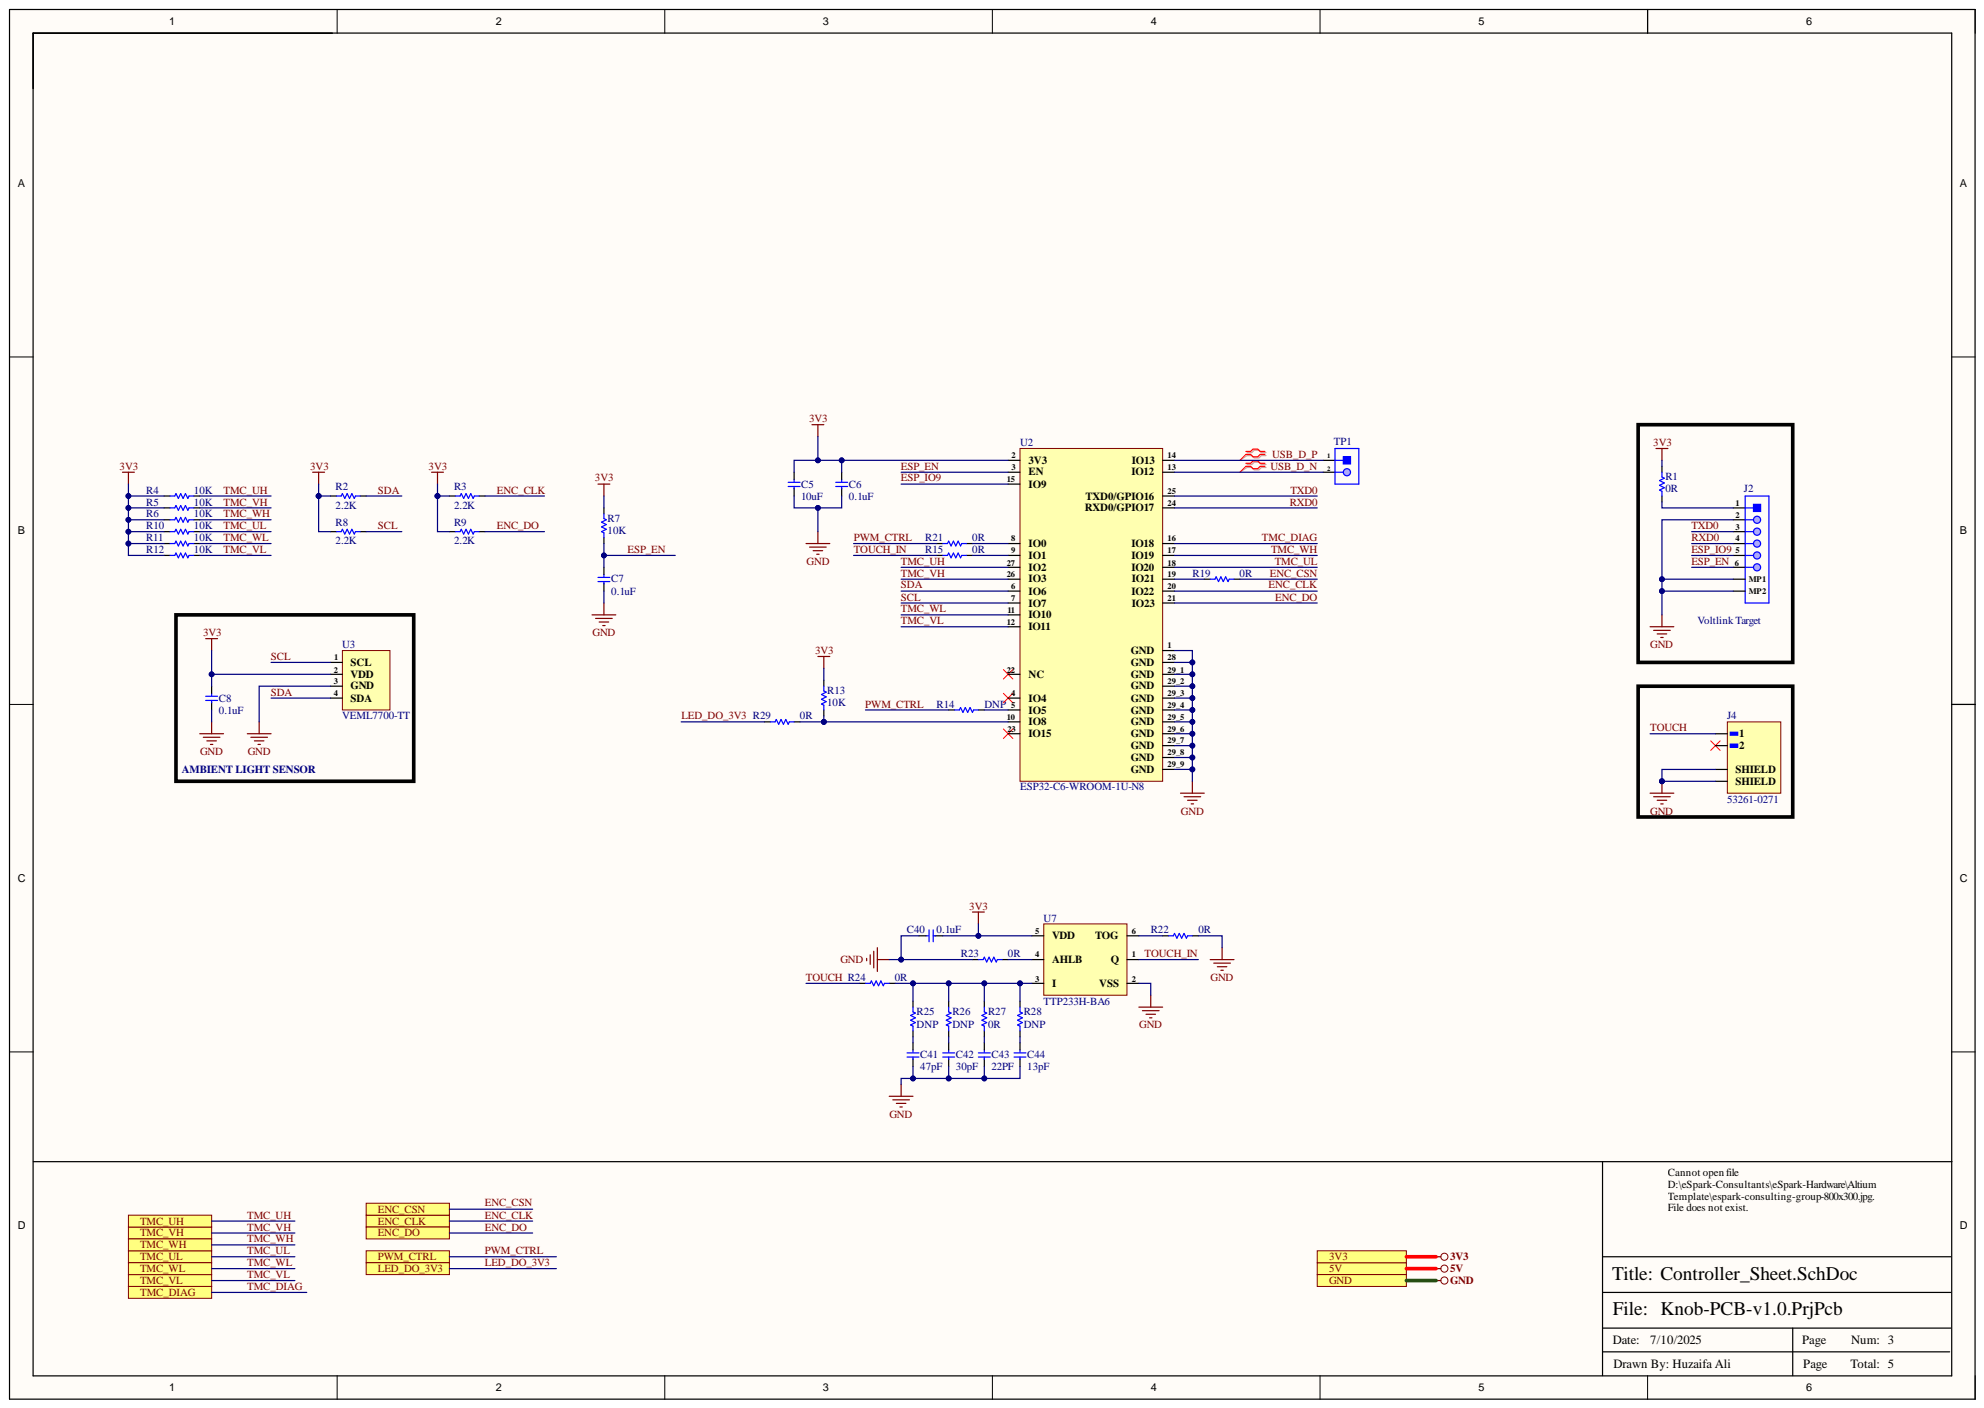
[picture p30: page 3]
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

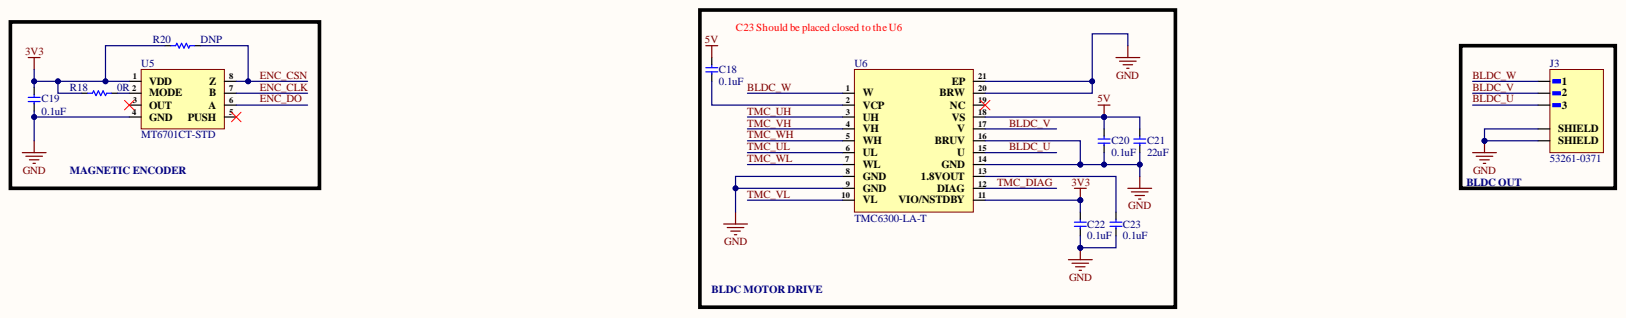
[picture p31: page 4]

C23 Should be placed closed to the U6

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

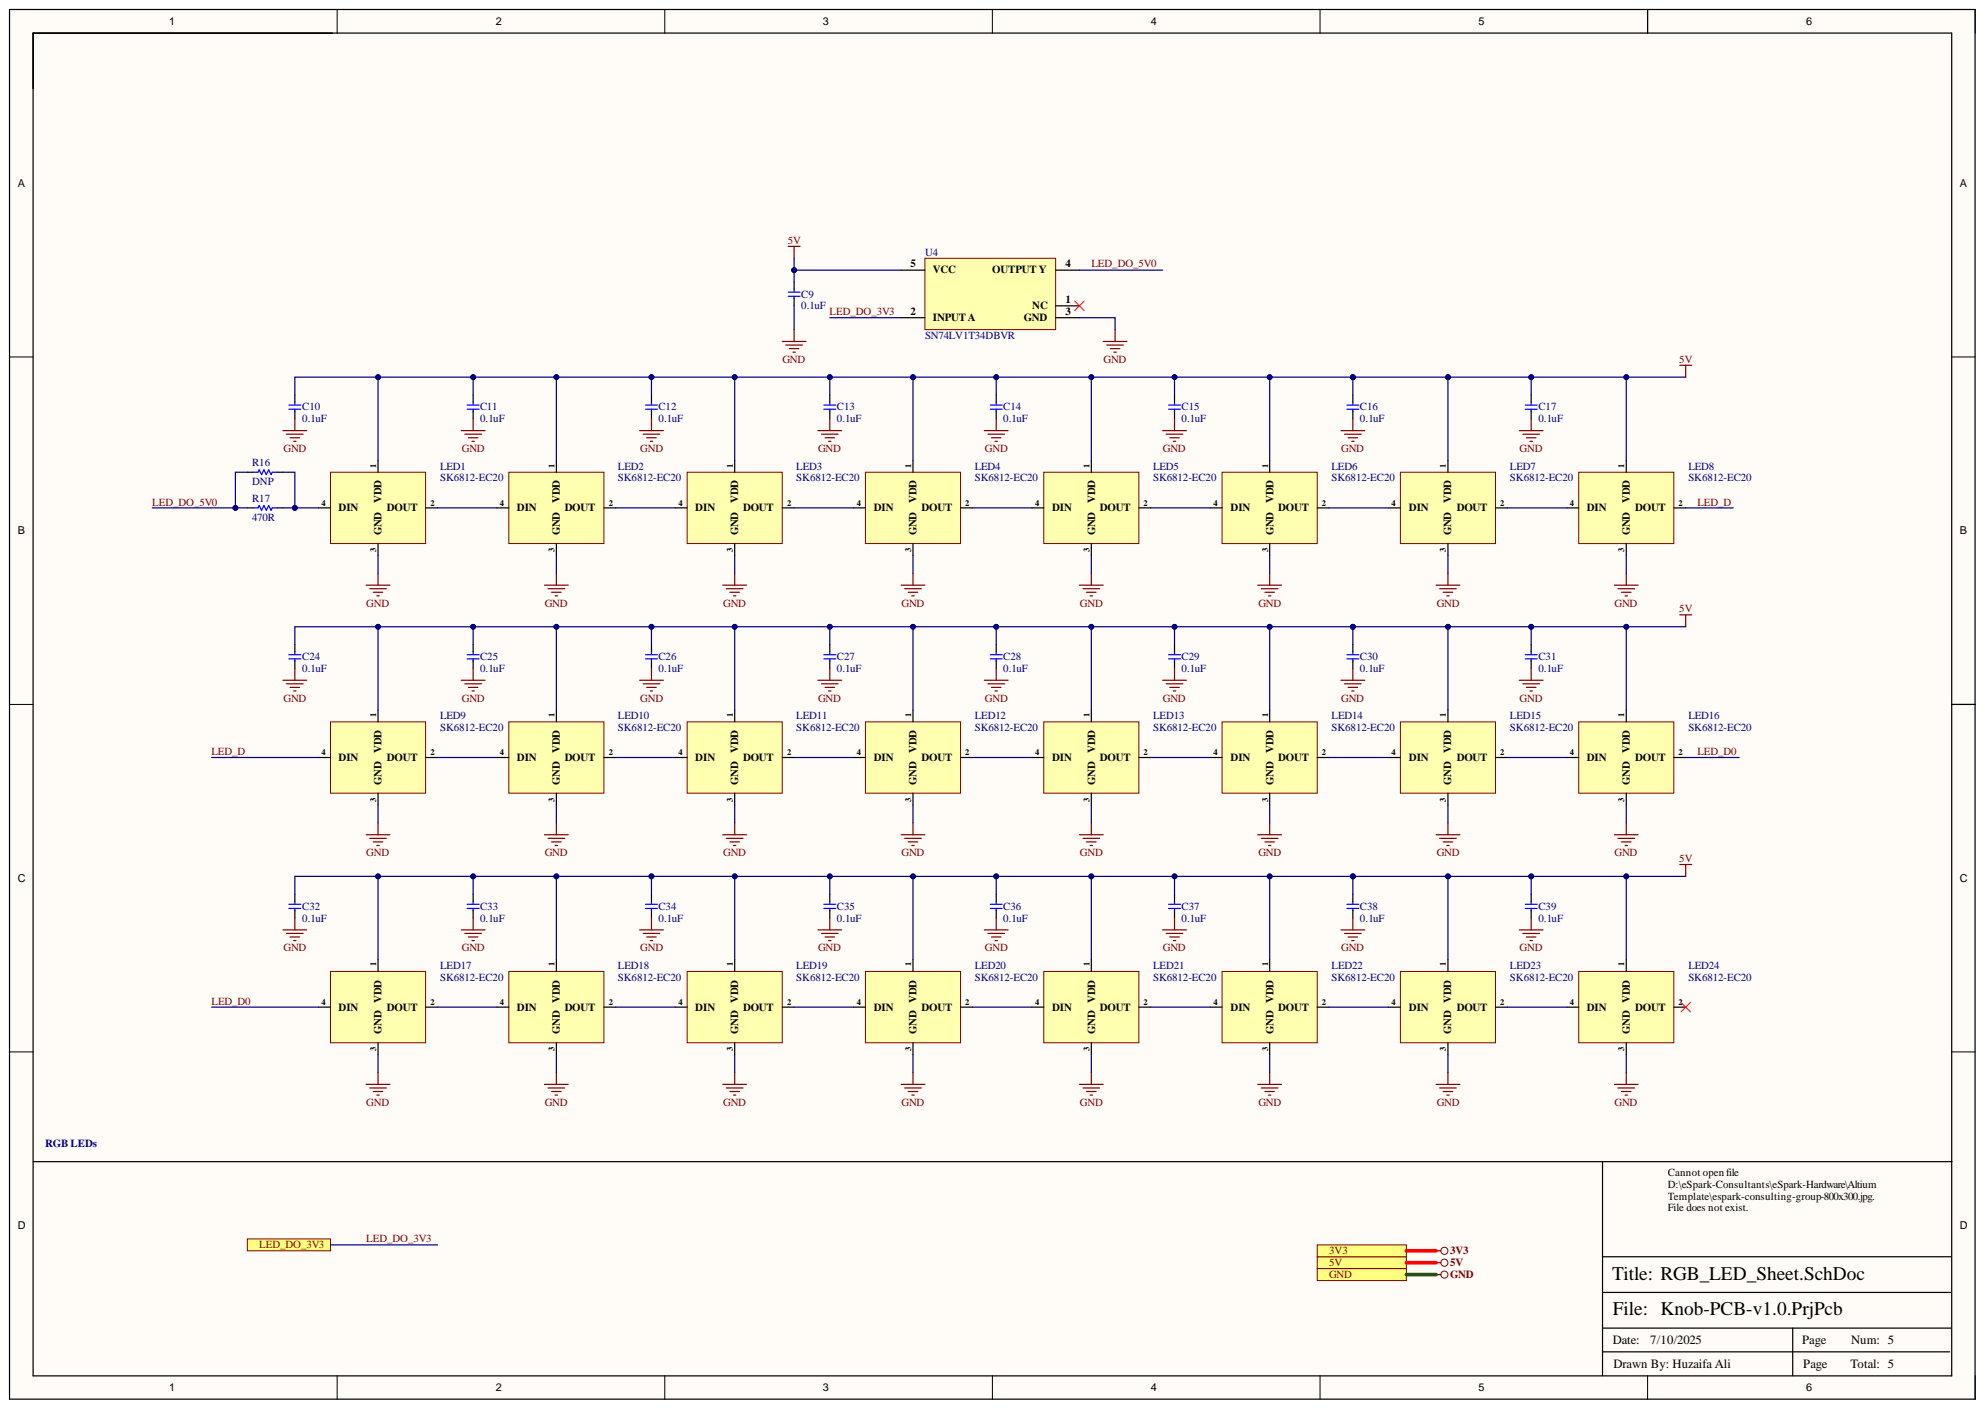
[picture p32: page 5]
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

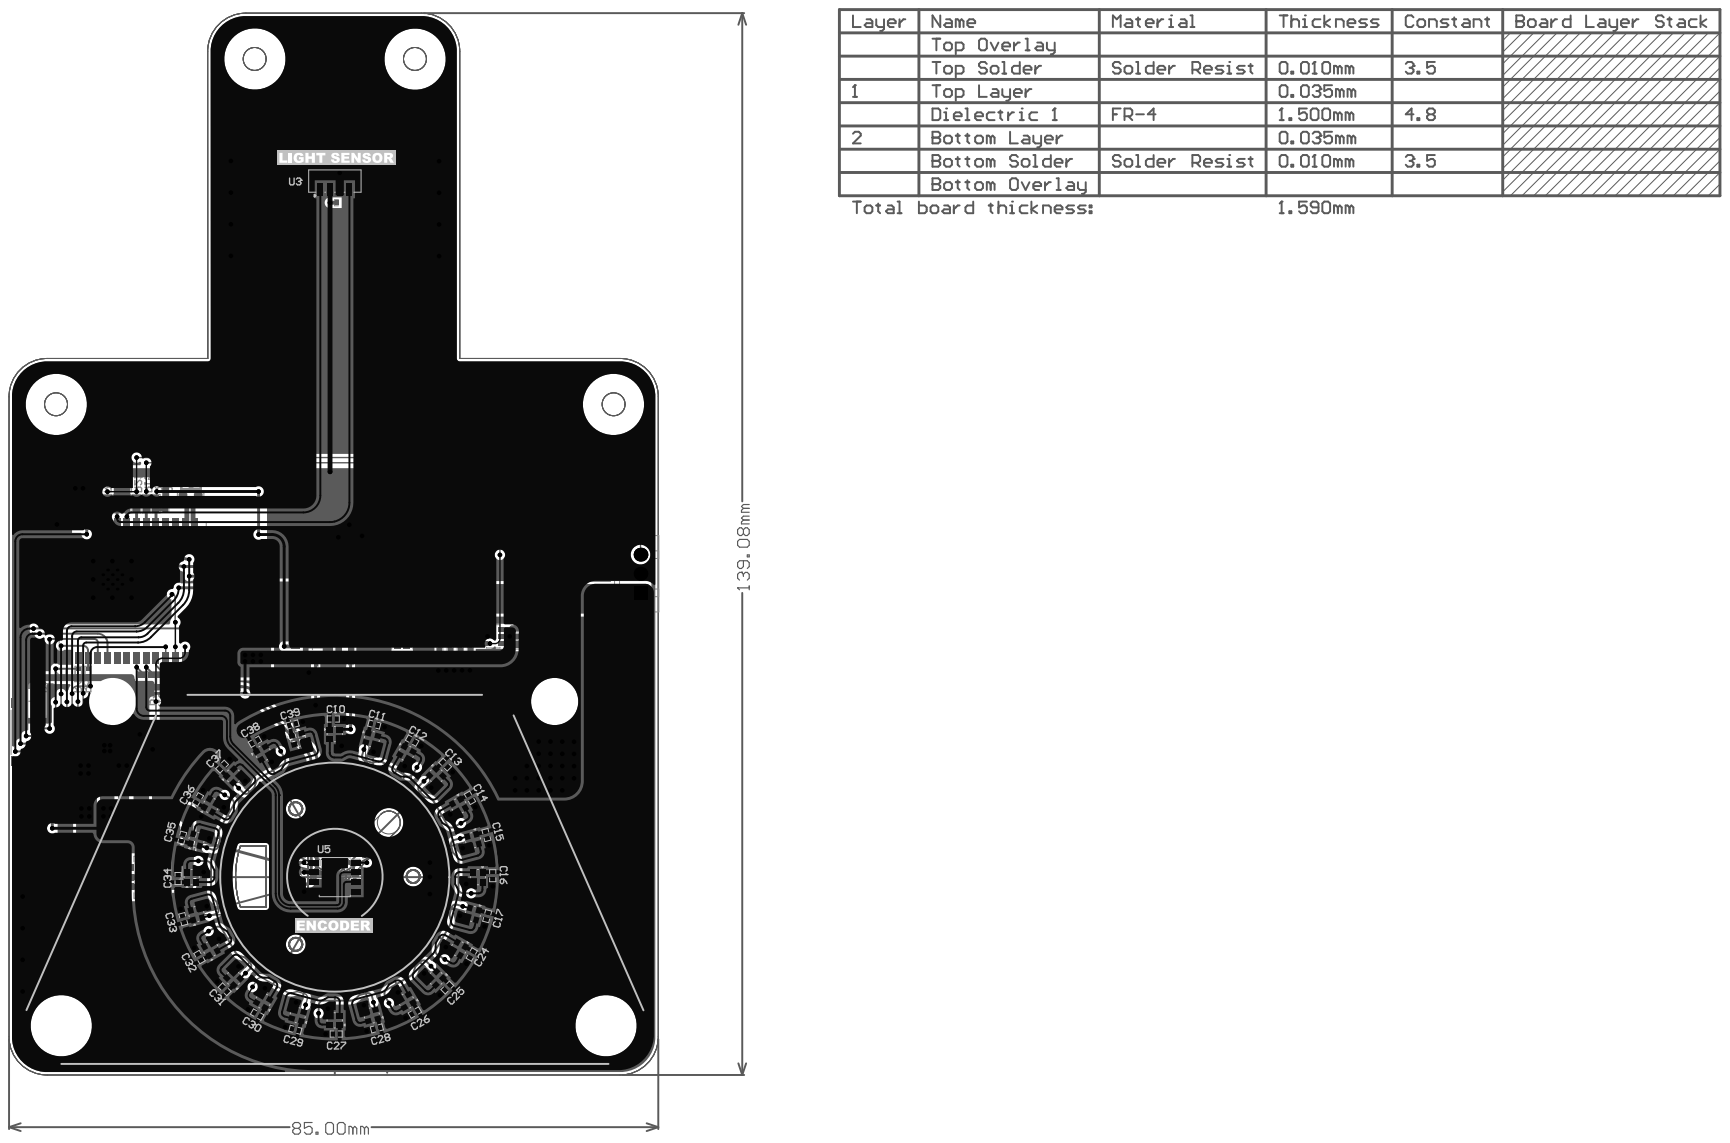
[picture p33: page 6]
