eSpark-Backup/dustinm-lampleddriver/Design-Files/Power-PCB-v1.0/Deliverables/Schematic/Power-PCB-v1.0.pdf

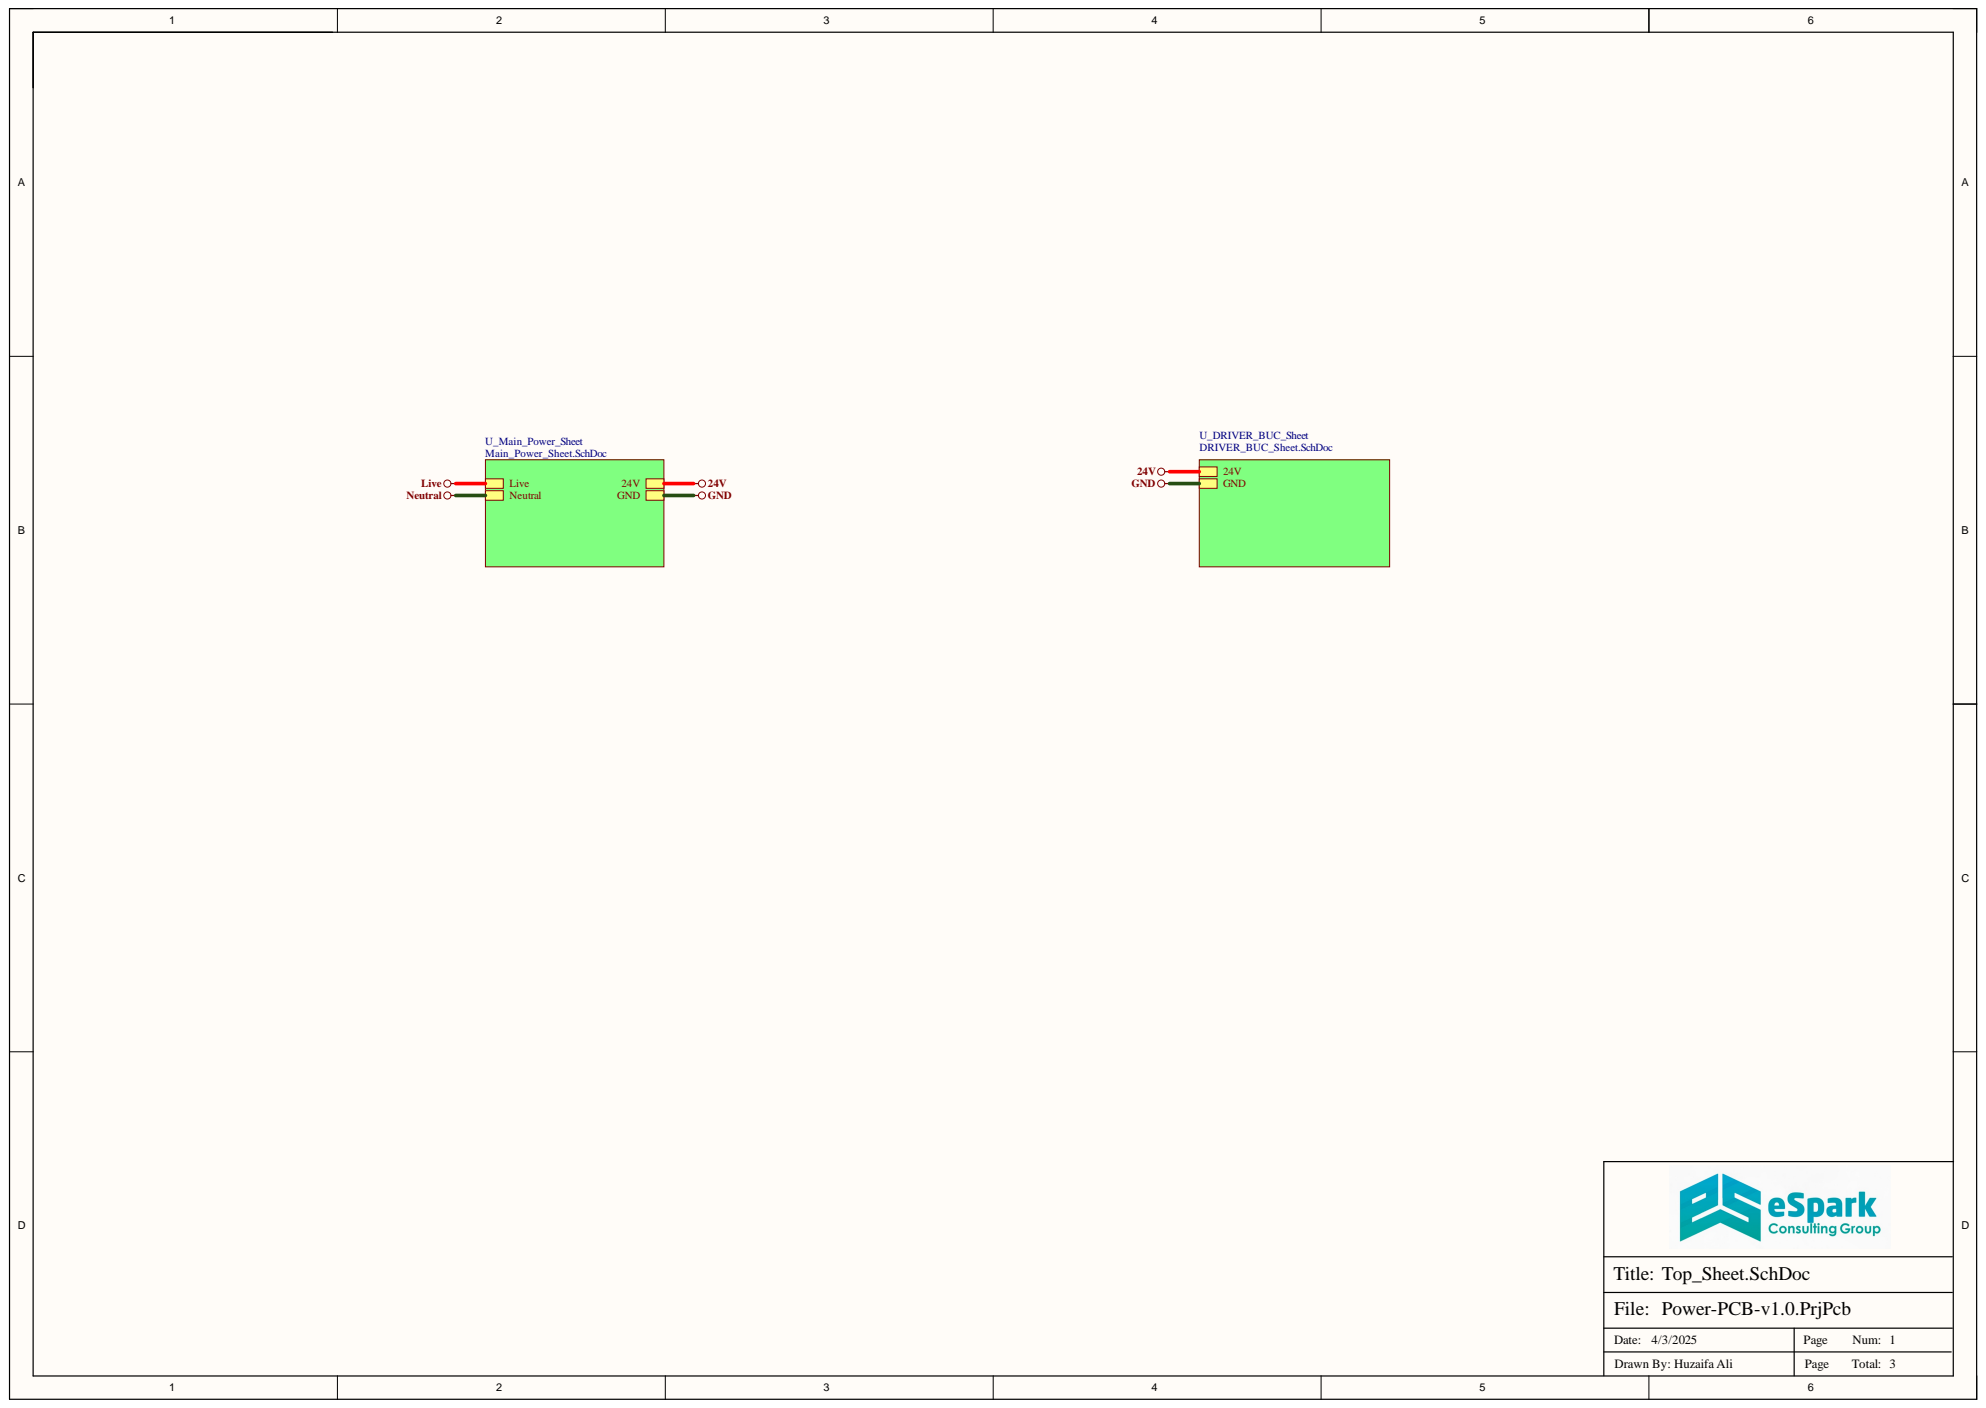
[picture p34: page 1]

Date: 4/3/2025 | Page Num: 1

Drawn By: Huzaifa Ali | Page Total:

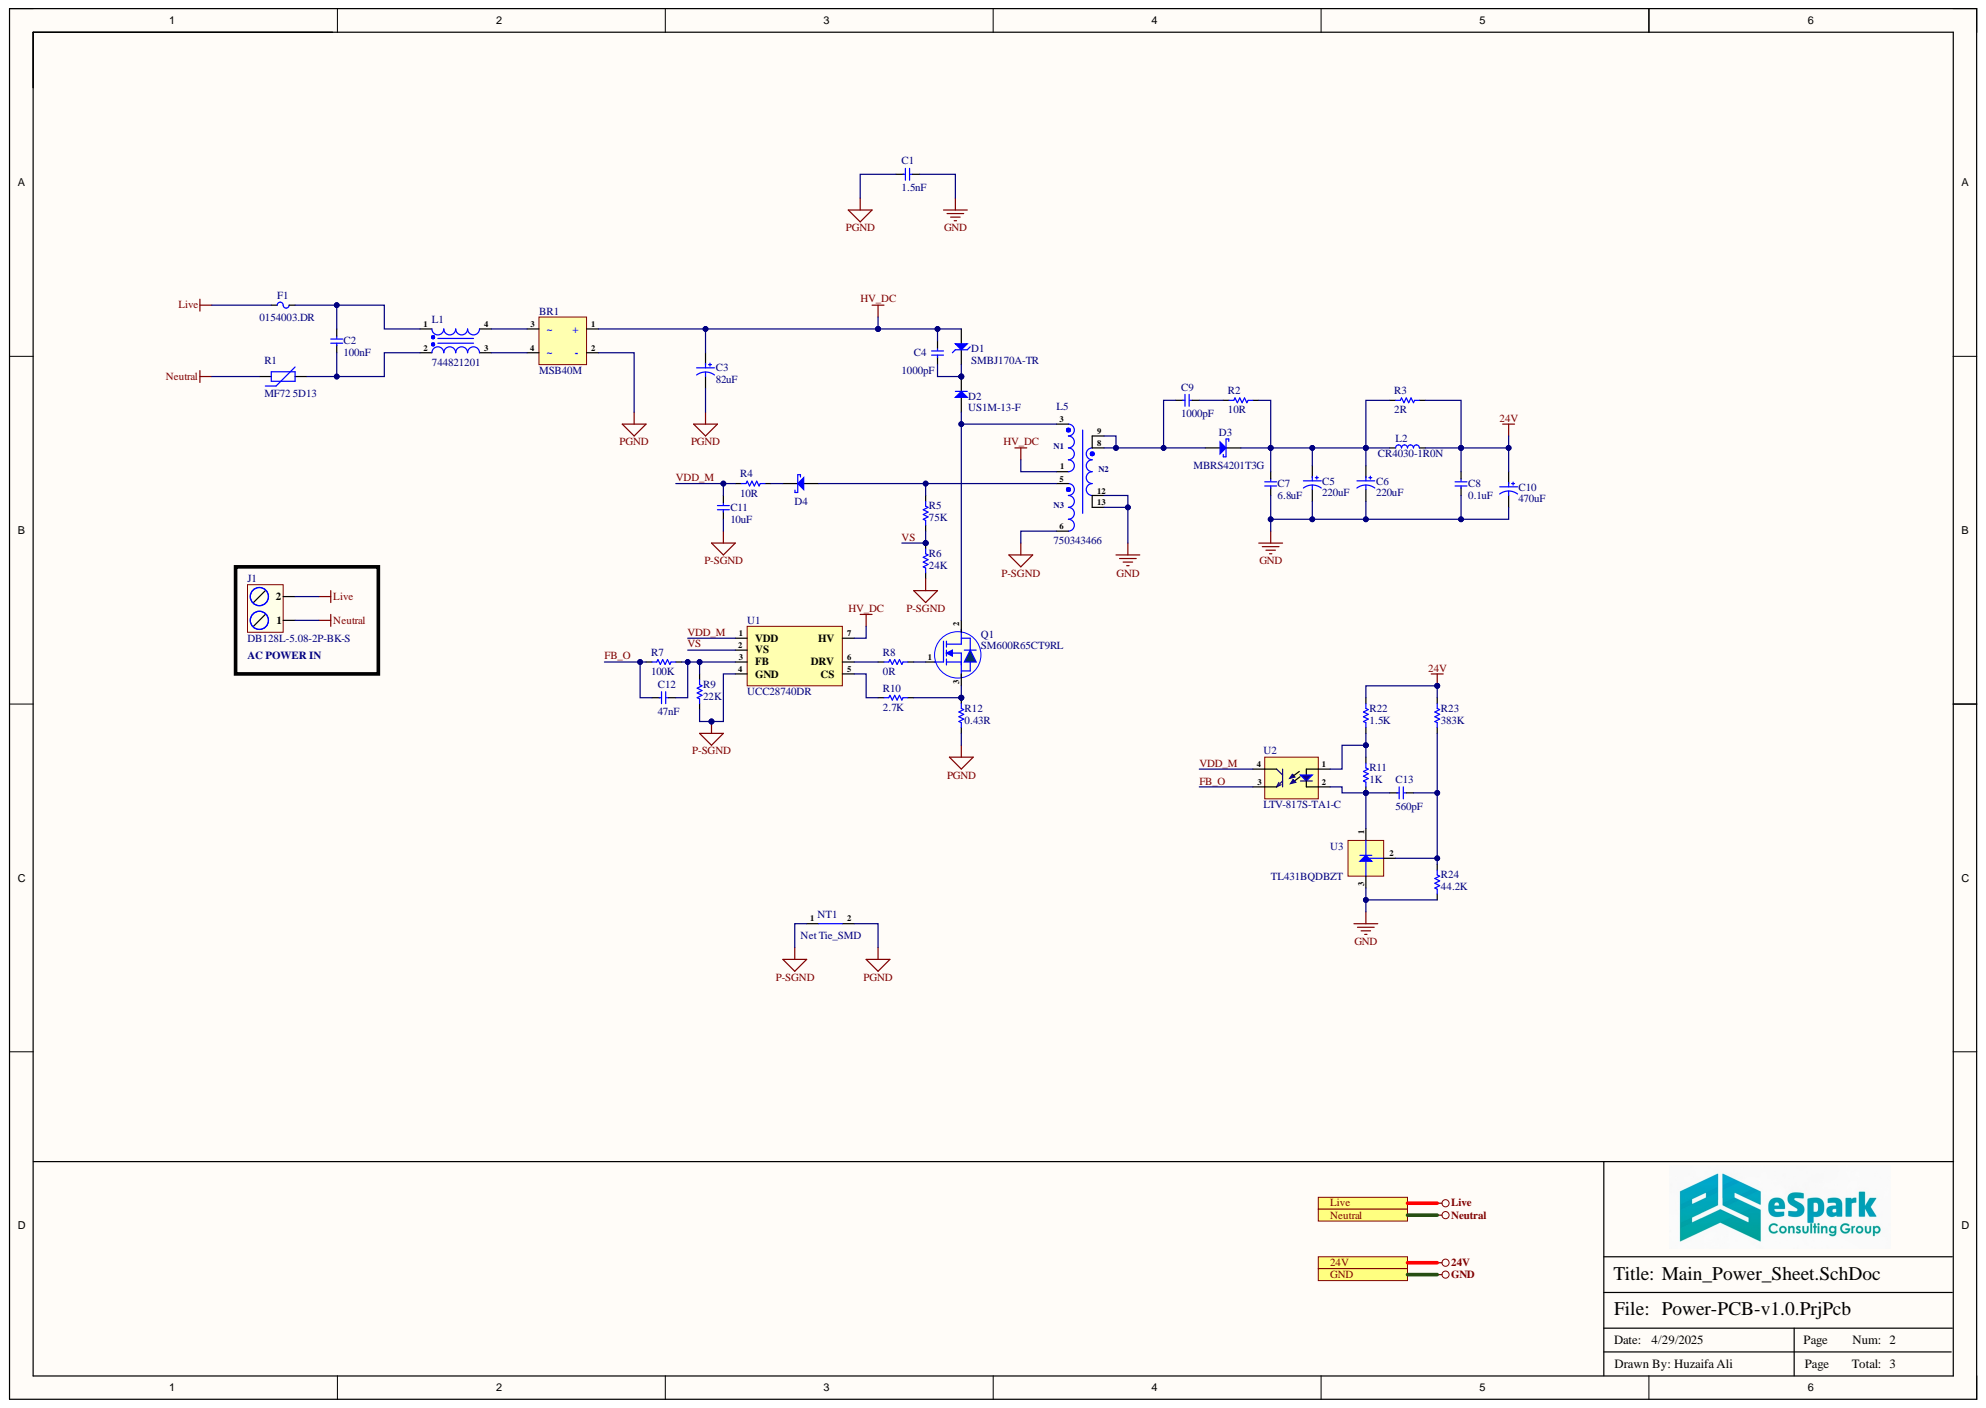
[picture p35: page 2]

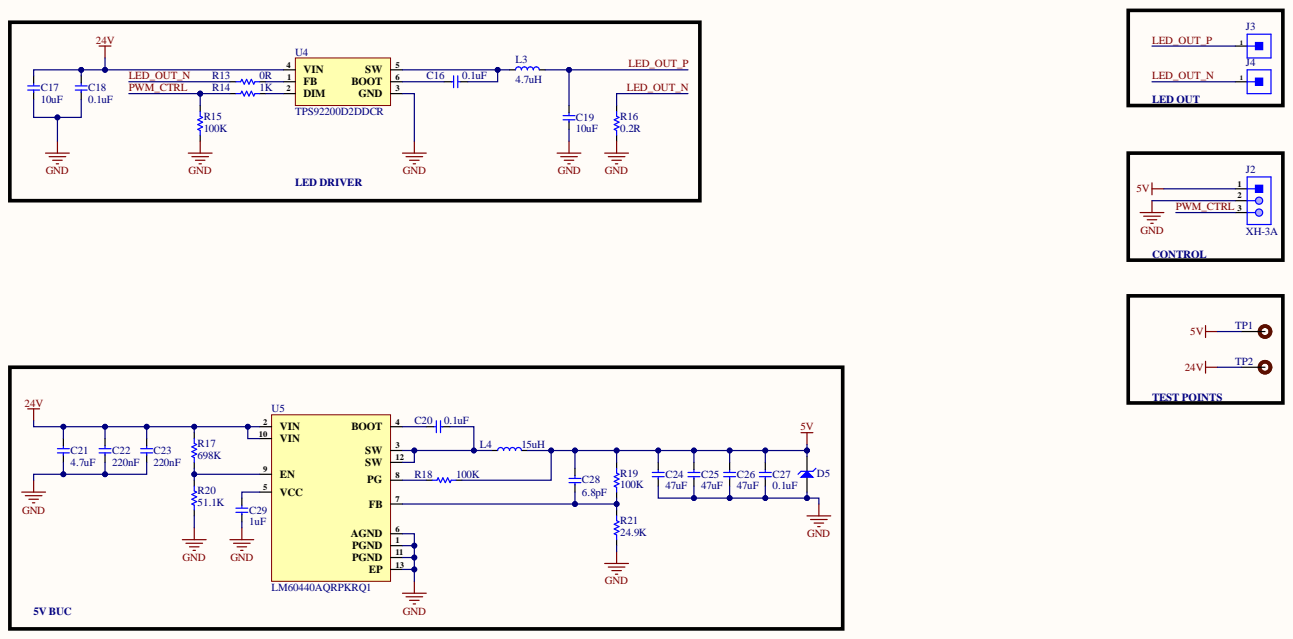
[picture p36: page 3]
