eSpark-Backup/dustinm-lampleddriver/(list of files, drawings)

Other design files:
Design-Files/Knob-PCB-v1.0/Controller_Sheet.SchDoc
Design-Files/Knob-PCB-v1.0/Knob-PCB-v1.0.PrjPcb
Design-Files/Knob-PCB-v1.0/Knob-v1.0.PcbDoc
Design-Files/Knob-PCB-v1.0/Motor_Encoder_Sheet.SchDoc
Design-Files/Knob-PCB-v1.0/Power_Sheet.SchDoc
Design-Files/Knob-PCB-v1.0/RGB_LED_Sheet.SchDoc
Design-Files/Knob-PCB-v1.0/Top_Sheet.SchDoc
Design-Files/Power-PCB-v1.0/DRIVER_BUC_Sheet.SchDoc
Design-Files/Power-PCB-v1.0/Main_Power_Sheet.SchDoc
Design-Files/Power-PCB-v1.0/Power-PCB-v1.0.PcbDoc
Design-Files/Power-PCB-v1.0/Power-PCB-v1.0.PrjPcb
Design-Files/Power-PCB-v1.0/Top_Sheet.SchDoc
