eSpark-Backup/dustinm-lampleddriver/(commit log)

2025-03-11 Add: Client enclosure files
    [lamp_body.step]
2025-03-17 Add: led pcb mockup and AC power input location step file
    [LED_board_mockup.step, lamp_base_with_konb_and_cord_hole.step]
2025-03-18 Add: triangular base step file
    [Lamp_triangular_base v1.step]
2025-03-26 #2 Project Files Created
    [Main_Power_Sheet.SchDoc, Power-PCB-v1.0.PrjPcb]
2025-03-27 #2 All Sheets Updated
    [DRIVER_BUC_Sheet.SchDoc, Main_Power_Sheet.SchDoc, Power-PCB-v1.0.PrjPcb, Top_Sheet.SchDoc]
2025-03-28 #2 Transformer symbol updated
    [Main_Power_Sheet.SchDoc, Power-PCB-v1.0.PrjPcb]
2025-03-28 #3 All Sheets Updated
    [Controller_Sheet.SchDoc, Knob-PCB-v1.0.PrjPcb, Motor_Encoder_Sheet.SchDoc, Power_Sheet.SchDoc, Top_Sheet.SchDoc]
2025-03-28 #3 PDF Updated
    [Controller_Sheet.SchDoc, Knob-PCB-v1.0.PrjPcb]
2025-04-03 #3 #2 Minor changes performed
    [Controller_Sheet.SchDoc, Main_Power_Sheet.SchDoc, Motor_Encoder_Sheet.SchDoc, Power_Sheet.SchDoc]
2025-04-03 #2 Fuse replaced in Main_Power-Sheet
    [Main_Power_Sheet.SchDoc]
2025-04-04 Fix: enclosure file latest updated
    [LED_board_mockup.step, Lamp_rectangular_base v2.step, Lamp_triangular_base v1.step, lamp_base_with_konb_and_cord_hole.step, lamp_body.step]
2025-04-08 #7 Progress: PCB shape to be changed
    [Knob-PCB-v1.0.PrjPcb, Knob-v1.0.PcbDoc]
2025-04-08 #6 #7 In Progress
    [Main_Power_Sheet.SchDoc, Power-PCB-v1.0.PcbDoc, Power-PCB-v1.0.PrjPcb]
2025-04-09 #7 #6 DxF added
    [Knob-v1.0.PcbDoc, Power-PCB-v1.0.PcbDoc]
2025-04-11 Add: Latest casing step files
    [Lamp_rectangular_base v11_175mm.step, Lamp_rectangular_base v11_180mm.step]
2025-04-11 #2 Main_Power_Sheet Updated, Transformer & driver changed
    [Main_Power_Sheet.SchDoc, Power-PCB-v1.0.PcbDoc]
2025-04-11 #7 In-progress
    [Controller_Sheet.SchDoc, Knob-v1.0.PcbDoc]
2025-04-14 #2 LED OUT JST replaced with PADs
    [DRIVER_BUC_Sheet.SchDoc, Main_Power_Sheet.SchDoc]
2025-04-14 #7 New Board Shape implemented.
    [Knob-PCB-v1.0.PrjPcb, Knob-v1.0.PcbDoc, Knob-v1.0.step]
2025-04-14 #6 New Board Shape defined, in-progress
    [Knob-StraightLED-v1.0.PcbDoc]
2025-04-18 #6 Final as per current requirement
    [Power-PCB-v1.0.PrjPcb]
2025-04-23 Change: move old enclosure files to archive
    [LED_board_mockup.step, Lamp_rectangular_base v2.step, Lamp_triangular_base v1.step, lamp_base_with_konb_and_cord_hole.step, lamp_body.step]
2025-04-23 Add: motor mount step file for Knob PCB
    [Lamp_rectangular_base v11_175mm.step, Lamp_rectangular_base v11_180mm.step, Motor_mount_knob_PCB_dummy.step]
2025-04-23 Remove: 180mm enclosure step variant (not going to be used)
    [Lamp_rectangular_base v11_180mm.step]
2025-04-28 Add: power pcb step file updated
2025-04-28 Add: updated knob PCB step files
    [Motor_mount_knob_PCB_dummy.step]
2025-04-28 #7 Replace: Right Angle LEDs to Straight LEDs
    [Controller_Sheet.SchDoc, Knob-v1.0.PcbDoc]
2025-04-28 #7 In Progress
    [Knob-PCB-v1.0.PrjPcb, Knob-v1.0.PcbDoc]
2025-04-29 #7 Backup Commit
    [Knob-v1.0.PcbDoc]
2025-05-02 #1 New_step_file
    [knob_pcb_with_motor_mount_4-29-25.step]
2025-05-02 #7 #3 Number of LEDs increased, In Progress
    [Controller_Sheet.SchDoc, Knob-PCB-v1.0.PrjPcb, Knob-v1.0.PcbDoc, RGB_LED_Sheet.SchDoc, Top_Sheet.SchDoc]
2025-05-05 #7 ESP32-S3 changed to ESP32-S3-U, PCB Placement updated
    [Controller_Sheet.SchDoc, Knob-v1.0.PcbDoc]
2025-05-06 #6 PCB Board outline updaetd
    [Power-PCB-v1.0.PcbDoc]
2025-05-07 #6 Net cleared, In Progress
    [Power-PCB-v1.0.PcbDoc]
2025-05-08 #6 #7 Power_PCB routing completed, Knob_PCB In Progres
    [Controller_Sheet.SchDoc, Knob-v1.0.PcbDoc, Power-PCB-v1.0.PcbDoc]
2025-05-09 #7 Routing In Progress
    [Knob-v1.0.PcbDoc]
2025-05-16 #7 PCB Routing Completed
    [Knob-v1.0.PcbDoc]
2025-05-19 #7 STEP file added
    [Knob-v1.0.step]
2025-06-02 #7 Changes Completed and Renderings plus Step3D generated
    [Knob-v1.0.DXF, Knob-v1.0.PcbDoc, Knob-v1.0.step]
2025-06-02 #6 Power_PCB Updated
    [DRIVER_BUC_Sheet.SchDoc, Power-PCB-v1.0.PcbDoc, Power-PCB-v1.0.PrjPcb, knob-board-hole-update.step]
2025-06-05 #7 Design Updated and Deliverables Generated
    [Centroid File.csv, Knob-PCB-v1.0.PrjPcb, Knob-v1.0..DWG, Knob-v1.0.DXF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]
2025-06-05 #6 Deliverables Updated
    [Centroide File.csv, Client-BOM_Power-PCB-v1.0.xlsx, Pick Place for Power-PCB-v1.0.csv, Power-PCB-v1.0.DXF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]
2025-06-06 #7 BOM added
    [Client_BOM_Knob-PCB-v1.0.xlsx]
2025-06-19 #9 #8 Order Placement Completed.
    [Client-BOM_Power-PCB-v1.0.xlsx, Client_BOM_Knob-PCB-v1.0.xlsx, JLCPCB-BOM-Knob-PCB-v1.0.xlsx, JLCPCB-BOM-Power-PCB-v1.0.xlsx]
2025-06-25 #8 Motor Peripheral added in Knob BOM
    [Client_BOM_Knob-PCB-v1.0.xlsx]
2025-07-09 #3 ESP32-S3 replaced with ESP32-C6 and touch IC added
    [Controller_Sheet.SchDoc]
2025-07-09 #3 PWM Control pin changed PDF updated.
    [Controller_Sheet.SchDoc, Knob-PCB-v1.0.PrjPcb]
2025-07-10 #7 Completed and Deliverables generated
    [Centroid_File.csv, Client_BOM_Knob-PCB-v1.0.xlsx, Controller_Sheet.SchDoc, JLCPCB-BOM-Knob-PCB-v1.0.xlsx, JLC_BOM_Knob-PCB-v1.0.xlsx, Knob-PCB-v1.0.PrjPcb, Knob-v1.0..DWG, Knob-v1.0.DWG]
2025-07-10 #7 Pick_n_place/Centroid updated
    [Centroid_File.csv, Pick Place for Knob-v1.0.csv]
2025-07-10 Client BOM added.
    @basit-eSpark Bhai Knob Board ka client BOM update kr dia ha.
    [Client-BOM_Knob-PCB-v1.0.xlsx, Client_BOM_Knob-PCB-v1.0.xlsx]
2025-07-11 PCBway Order Placed.
